ajayspatil7/solar-detect/solar_defect_camera/design/phase2-qa-comparison.png

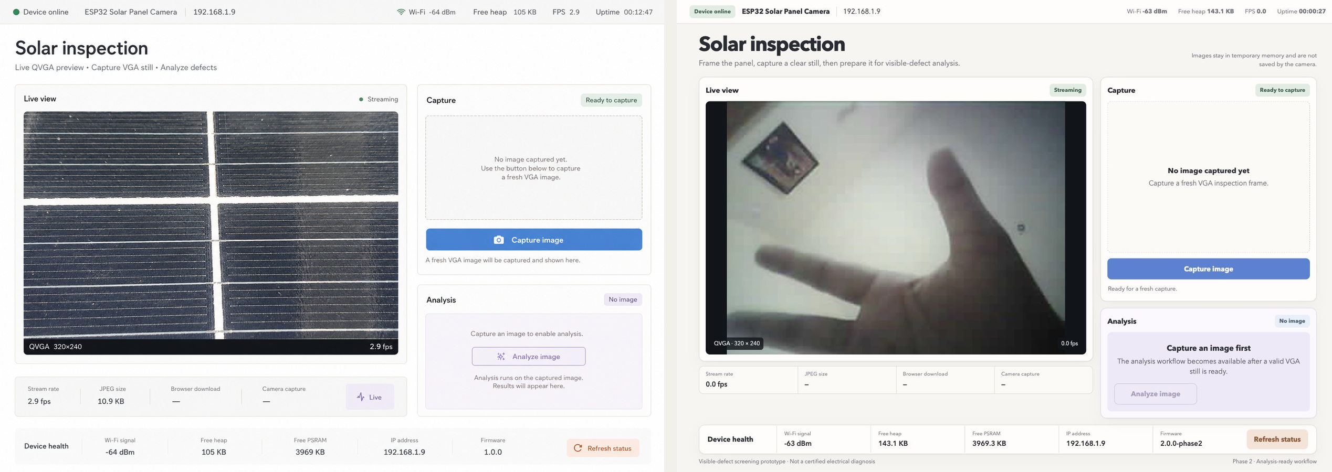
solar_defect_camera/design/phase2-qa-comparison.png
