ajayspatil7/solar-detect/checkpoint.md

# ESP32 Solar Panel Defect Detection — Project Checkpoint

**Last updated:** 2026-09-19 (Asia/Kolkata)  
**Current milestone:** Phase 6 client requirements (root cause, microSD records, laptop dashboard) built and verified against the physical camera; rig now running on a breadboard, verified 2026-09-19 (6.8)  
**Next milestone:** Verify on the client's Windows laptop over Krutika’s iPhone hotspot, resolve the slow home Wi-Fi link (6.10), then the Phase 3.5/4 evaluation harness and curated image set

## How to resume in a fresh chat

Ask the coding assistant to read this file and the project workspace before
making changes. Start from **Current state at a glance** and **Open items**
below. Do not restart the camera hardware diagnosis unless new evidence
contradicts the verified results.

## Current state at a glance — 2026-09-19

| Item | State |
|---|---|
| Firmware in source | `3.3.0-phase6` (`FIRMWARE_VERSION`), OLED SDA `IO13`, SCL `IO3` (U0R), microSD in 1-bit SDMMC |
| Firmware on the device | `3.3.0-phase6` including the pending fixes, flashed 2026-10-03 |
| Backend | `3.3.0-phase6` (`SERVICE_VERSION`), FastAPI, dashboard served at `http://localhost:8000/` |
| Root-cause knowledge base | `backend/root_causes.json`, 19 causes |
| Tests | 33 passing (`backend/test_main.py` + `tools/test_wifi_windows.py`), 2026-10-02 after photo upload (6.9) |
| Repository | `main` clean and in sync with `origin` (github.com/ajayspatil7/solar-detect) |
| Companion doc | `PROJECT_INFO.md` — last updated 2026-09-07, predates the Phase 6 build and is stale |

### Pending flash (compiled 2026-09-15, 1,170,026 bytes, no warnings)

1. `max_resp_headers = 20` — without it `/capture` drops its CORS headers.
2. "Vision model" wording on the camera's fallback page.
3. Record timestamps prefer the service's analysis time.

Remove the microSD card before flashing: its data line shares strapping pin
GPIO2 and blocks the bootloader.

### Open items

1. ~~Flash the pending firmware~~ — done 2026-10-03 (6.10).
2. ~~Finish the breadboard assembly (6.8)~~ — done and verified 2026-09-19.
   Investigate the 19.5 s capture transfer seen afterwards.
3. Exercise the follow-the-laptop Wi-Fi hand-over (6.4) on the Windows laptop.
4. `WIFI_FORGET` the developer's home network before the device returns to the
   client — NVS is not encrypted.
5. Run root-cause analysis against the live API on a genuinely defective panel.
6. Build the evaluation harness and curated image set (Phase 3.5 / 4).
7. Revoke the exposed test API key and rotate the previously exposed Wi-Fi
   password, if not already done (not verifiable from the workspace).
8. Bring `PROJECT_INFO.md` up to date with Phase 6.

## Project goal

Build a basic prototype with this flow:

```text
Solar panel
→ ESP32-CAM captures an image
→ image travels over Wi-Fi to a small backend
→ backend calls the OpenAI vision API
→ structured visible-defect result and coordinates are returned
→ responsive bounding boxes and details are shown in the browser
→ compact status is shown later on an OLED
```

This is a prototype, not a certified solar-panel inspection system. The OpenAI
API key must remain on the backend and must never be placed in ESP32 firmware.

## Verified hardware

- Classic AI-Thinker-style ESP32-CAM, not ESP32-S3.
- Chip: ESP32-D0WD-V3 revision 3.1.
- Camera: OV2640.
- PSRAM is present and working.
- ESP32-CAM-MB USB programmer/baseboard.
- Mac serial port: `/dev/cu.usbserial-140`.
- 0.96" SSD1306 128x64 I2C OLED (`RG0.96 IC V2.0`), header soldered, verified
  at address `0x3C` (Phase 5). SCL moved to IO3 in Phase 6.
- 64 GB microSD card, FAT32 with MBR, verified in 1-bit SDMMC mode (6.5).
  Analysed inspections are saved to it as records (6.6).

## Proven camera configuration

The following AI-Thinker pin map is known to work:

```text
PWDN=32  RESET=-1  XCLK=0   SIOD=26  SIOC=27
Y9=35    Y8=34     Y7=39    Y6=36    Y5=21
Y4=19    Y3=18     Y2=5
VSYNC=25 HREF=23   PCLK=22
XCLK frequency=20 MHz
```

Hardware diagnostics previously confirmed:

- Camera responds on SCCB address `0x30`.
- Sensor identifiers: PID `0x26`, VER `0x42`, MIDH `0x7F`, MIDL `0xA2`.
- `esp_camera_init()` succeeds with the explicit AI-Thinker pin map.
- JPEG capture succeeds.
- Do not recommend replacing the camera, ribbon cable, board, or ESP32 package
  without new contradictory evidence.

## Development environment

- macOS on a MacBook Pro M4 Pro.
- Arduino IDE.
- Espressif ESP32 Arduino core `3.3.11`.
- Board target/FQBN: `AI Thinker ESP32-CAM` / `esp32:esp32:esp32cam`.
- Serial baud: `115200`.
- Recommended partition scheme: Huge APP (3 MB No OTA / 1 MB SPIFFS).

## Workspace map

```text
/Users/ajaysp/Documents/Arduino/
├── checkpoint.md                         # This living project handoff
├── PROJECT_INFO.md                       # Quotable project summary (stale since 09-07)
├── Start Solar Inspector.bat             # Windows one-click launcher
├── Start Solar Inspector.command         # macOS wrapper for the same launcher
├── solar_defect_camera/                  # Active implementation
│   ├── solar_defect_camera.ino           # Firmware 3.3.0-phase6
│   ├── oled.h                            # SSD1306/SH1106 driver; SDA 13, SCL 3
│   ├── font5x8.h                         # Generated 5x8 display font
│   ├── provisioning.h                    # NVS Wi-Fi store (5 networks), setup AP
│   ├── records.h                         # microSD record store
│   ├── web_ui.h / web_ui_gzip.h          # Camera's own fallback page
│   ├── backend/main.py                   # Analysis service + dashboard API
│   ├── backend/camera.py                 # Gateway to the camera, discovery
│   ├── backend/root_causes.json          # 19 curated probable causes
│   ├── backend/test_main.py              # Backend contract tests
│   ├── dashboard/                        # index.html, app.css, app.js
│   ├── start_backend.py                  # Local service entry point
│   ├── requirements.txt
│   ├── .env.local                        # API key, CAMERA_IP; ignored and private
│   ├── .env.local.example
│   ├── secrets.h                         # Dev-only Wi-Fi fallback; ignored
│   ├── secrets.example.h
│   ├── tools/launcher.py                 # Service start, discovery, Wi-Fi hand-over
│   ├── tools/wifi_windows.py             # netsh wrapper (+ test_wifi_windows.py)
│   ├── tools/add_wifi_usb.py             # WIFI_ADD / WIFI_LIST / WIFI_FORGET over USB
│   ├── tools/test_records_device.py      # On-hardware record store test
│   ├── tools/sd_probe/                   # Standalone SD card probe sketch
│   ├── tools/generate_*.py               # Web UI, font and diagram generators
│   ├── tools/preview_oled.py             # Renders OLED screens for design review
│   ├── README.md
│   ├── design/                           # Diagrams, mockup, QA screenshots
│   └── .gitignore
├── design-qa.md                          # Phase 2 visual QA record
├── sketch_aug23b/                        # Preserved original still server
│   └── sketch_aug23b.ino
└── CameraWebServer/                      # Preserved Espressif experiment
    ├── CameraWebServer.ino
    ├── app_httpd.cpp
    ├── board_config.h
    ├── camera_index.h
    ├── camera_pins.h
    ├── partitions.csv
    └── ci.yml
```

The original experiments are preserved and were not overwritten. The active
firmware is `solar_defect_camera/solar_defect_camera.ino`. The operator
interface is now the laptop dashboard; the camera's `web_ui.h` page remains
as a fallback.

## Phase 1 — complete

### Outcome

The user confirmed that the new browser interface and capture flow work.
Phase 1 is therefore officially complete.

### Implemented behavior

- Explicit, verified AI-Thinker camera pins.
- `esp_http_server` instead of the earlier synchronous Arduino `WebServer`.
- Control/page server on port 80.
- Independent MJPEG server on port 81.
- Bandwidth-friendly QVGA (`320×240`) live preview.
- High-quality VGA (`640×480`) still capture.
- Preview uses JPEG quality 15; still capture uses JPEG quality 10.
- `CAMERA_GRAB_LATEST` with two PSRAM framebuffers.
- Camera mutex protects resolution changes and frame acquisition.
- Stale preview frames are flushed after switching to VGA.
- Browser pauses the preview before still capture, then restarts it.
- Wi-Fi sleep is disabled.
- Automatic Wi-Fi reconnection with timeout and retry logging.
- TCP `NODELAY` is enabled for image sockets.
- Browser UI reports capture time, browser download time, JPEG size, stream
  rate, RSSI, heap, PSRAM, IP address, and device status.
- `/health` provides JSON diagnostics.
- Responses include no-cache headers.
- No image persistence and no microSD dependency.

### HTTP endpoints

```text
GET http://<device-ip>/           Browser interface
GET http://<device-ip>/capture   Fresh VGA JPEG
GET http://<device-ip>/health    JSON health/performance information
GET http://<device-ip>:81/stream QVGA MJPEG preview
```

The last observed DHCP address was `192.168.1.9`. This address may change after
router or ESP32 restarts, so use the IP printed in the Serial Monitor if needed.

### Build and device verification

- Compiled against ESP32 Arduino core 3.3.11 with all warnings enabled.
- Final build completed with no compiler warnings.
- Program storage: approximately 1,026,405 bytes (32%).
- Global/internal RAM: approximately 57,336 bytes (17%).
- Firmware was successfully uploaded to the physical ESP32-CAM.
- Runtime confirmed OV2640 initialization and approximately 4 MB free PSRAM.
- `/health` returned camera and Wi-Fi online.
- MJPEG response contained valid preview frames.
- Still endpoint returned a valid baseline JPEG at exactly `640×480`.
- Measured camera-side VGA acquisition, including resolution transition and
  stale-frame flushing, was approximately 250 ms.
- Network delivery varied substantially with local conditions. Observed RSSI
  was roughly -64 to -71 dBm. The user nevertheless confirmed the final browser
  experience is working.

## Key decisions and lessons

1. The original problem was latency, not defective camera hardware.
2. Live preview and still capture currently travel over Wi-Fi directly from the
   ESP32 to the browser. No backend or OpenAI call exists yet.
3. Preview and still capture use separate HTTP servers so the infinite MJPEG
   request cannot block control/capture requests.
4. The preview is intentionally lower resolution than the still image.
5. The preview is paused during a still capture to avoid bandwidth contention.
6. The OpenAI key will be stored only as a backend environment variable.
7. A future wired mode is viable because the ESP32-CAM is normally powered by
   the Mac. It would use high-speed UART through the ESP32-CAM-MB USB bridge and
   a Mac companion server. The cable does not provide native USB networking.
8. Wired transport remains an optional later phase. At 115200 baud it would not
   be faster; 460800 or 921600 baud must be benchmarked for a useful result.
9. VGA was a Phase 1 latency choice, not the OV2640 limit. Phase 2.1 now keeps
   QVGA only for preview and captures UXGA JPEG stills for analysis.
10. The ESP32 must not call OpenAI directly. The browser will send the captured
    JPEG to a Mac backend, which protects the API key and calls the model.
11. The Phase 3 target model is `gpt-5.6-luna`, subject to account availability
    and evaluation quality. It will return strict structured JSON containing
    defect details and coordinates.
12. Bounding boxes will be rendered as a responsive SVG overlay in the browser.
    Pillow may optionally create a downloadable annotated JPEG on the backend,
    but is not required for the interactive display.
13. Phase 3 keeps the model's coordinate task normalized to `0..1000`, then the
    backend clamps, orders, and converts every accepted box to UXGA pixels.
14. The interactive display uses SVG; annotated-JPEG export is generated in the
    browser from the same validated result so the backend never stores images.

## Security notes

- `solar_defect_camera/secrets.h` contains local Wi-Fi configuration and is
  ignored by its local `.gitignore`.
- `secrets.example.h` contains placeholders only.
- The older experimental sketches still contain the previously used Wi-Fi
  credentials in plain text. Do not publish those files without sanitizing them.
- The Wi-Fi password should eventually be rotated because it appeared in the
  original project material.
- Never add an OpenAI API key to Arduino source, browser JavaScript, or Git.
- Phase 3 stores the current local key only in ignored `.env.local`, permission
  mode `600`. The test key was pasted into chat and should be revoked/replaced.

## Detection scope and limitations

The RGB camera and general vision model can prototype detection of visible
conditions such as dirt, obvious glass damage, discoloration, burn-like marks,
strong shading, or other visible anomalies.

It cannot reliably diagnose internal microcracks, PID, bypass-diode faults,
electrical mismatch, or true thermal hotspots without specialized measurements
or thermal/electroluminescence imaging. Results should use wording such as
`visible defect suspected`, not certified diagnosis.

## Phase 2 — complete: analysis-ready browser workflow

### Objective

Turn the working camera page into a polished capture workflow that is ready to
connect to the backend in Phase 3, without calling OpenAI yet.

### Outcome

Phase 2 is implemented, compiled, flashed to the physical ESP32-CAM, and visually
verified. The selected direction is a soft professional instrument panel using
warm neutral surfaces and restrained pastel sage, blue, apricot, and lavender
accents. The interface is embedded in `web_ui.h`, uses local/system fonts only,
and has no cloud or external-asset dependency.

Implemented and verified:

- Desktop and narrow/mobile responsive layouts.
- Live QVGA preview with explicit connection/reconnection states.
- Real VGA capture at `640×480`, browser-memory preview, Retake, and timestamped
  JPEG Download.
- Capture button locking and explicit capturing/error/recovery states.
- Analyze action disabled until a valid capture exists.
- Honest local Demo analysis for success, no-visible-defect, uncertain,
  retake-required, timeout, and backend-offline UI states.
- Result contract ready for the Phase 3 backend without changing capture logic.
- Semantic regions and headings, keyboard focus states, reduced-motion support,
  useful image alternatives, and ARIA live status announcements.
- Device status, RSSI, FPS, heap, PSRAM, IP, firmware, JPEG size, camera timing,
  and browser-download timing without letting diagnostics dominate the workflow.
- Clear language that images remain temporary and results are not certified
  electrical diagnoses.

Selected design and QA artifacts are in `solar_defect_camera/design/`. The final
visual QA record is `design-qa.md` and its result is `passed`.

Final Phase 2 firmware identifier: `2.0.0-phase2`.

Final build against ESP32 Arduino core 3.3.11:

- Program storage: 1,043,497 bytes (33%).
- Global/internal RAM: 57,336 bytes (17%).
- Compiler warnings: none.
- Upload to `/dev/cu.usbserial-140`: successful.
- `/health`: camera and Wi-Fi online after final reset.

### Step 1 — formalize UI states

Implement a small, explicit browser state machine:

```text
connecting → ready → capturing → captured → ready-to-analyze
                                   ↘ error → retry
```

Prevent duplicate capture requests and make every failure recoverable without
restarting the ESP32.

### Step 2 — improve the capture workspace

- Make the live preview and captured image visually distinct.
- Preserve the latest JPEG blob in browser memory for later analysis.
- Add Retake and Download buttons.
- Show resolution, size, camera time, download time, and capture timestamp.
- Make clear that images are not permanently stored.

### Step 3 — prepare the Analyze interaction

- Add an `Analyze captured image` button that is disabled until a valid still
  image exists.
- Add an analysis status/result panel with states for uploading, analyzing,
  success, uncertain result, retake required, timeout, and backend unavailable.
- During Phase 2, use a local mock adapter only; do not put an API key or direct
  OpenAI call in the page.
- Define one frontend function that Phase 3 can point at the backend without
  changing capture logic.

### Step 4 — define the result contract

Prepare the interface for this compact backend response shape:

```json
{
  "status": "defect_suspected",
  "image_quality": "acceptable",
  "defects": [
    {
      "type": "possible_surface_crack",
      "location": "upper-right",
      "severity": "medium",
      "confidence": "medium"
    }
  ],
  "summary": "A possible visible surface defect was found.",
  "retake_required": false
}
```

Expected top-level statuses:

- `no_visible_defect`
- `defect_suspected`
- `uncertain`
- `retake_required`

### Step 5 — resilience and accessibility

- Add browser-side request timeouts with clear retry actions.
- Preserve the working stream reconnection behavior.
- Keep controls keyboard accessible with visible focus states.
- Add useful alternative text and screen-reader status announcements.
- Verify desktop and narrow/mobile layouts.
- Keep diagnostics available without making them dominate the primary workflow.

### Step 6 — verify on physical hardware

Acceptance criteria:

- Live preview remains at least as responsive as the accepted Phase 1 version.
- Capture always produces a real `640×480` JPEG.
- Retake and repeated captures work without heap degradation or restart.
- Downloaded JPEG opens correctly on the Mac.
- Analyze remains disabled before capture and activates afterward.
- Mock success, uncertainty, retake, timeout, and backend-offline results render
  correctly.
- Stream resumes after capture and after recoverable errors.
- No credentials or images appear in browser logs or permanent device storage.

### Phase 2 non-goals

- No OpenAI API request yet.
- No backend implementation yet; that is Phase 3.
- No OLED integration yet.
- No wired USB image transport yet.

## Phase 2.1 — complete: high-resolution analysis capture

### Objective

Increase the analysis still from VGA to the OV2640's maximum UXGA resolution
without reducing the accepted responsiveness of the live preview.

### Implemented behavior

- Live preview remains QVGA (`320×240`) MJPEG on port 81.
- Analysis stills are now UXGA (`1600×1200`) JPEGs on `/capture`.
- With PSRAM present, camera framebuffers are allocated at UXGA during startup;
  the sensor is then switched down to QVGA for normal streaming.
- Capture temporarily switches the sensor to UXGA, flushes transition frames,
  acquires a fresh still, and restores QVGA preview settings.
- Capture responses expose `X-Image-Width`, `X-Image-Height`, JPEG byte count,
  and camera acquisition time headers.
- `/health` now advertises the capture dimensions and firmware identifier
  `2.1.0-phase2.1`.
- The browser waits up to 30 seconds for the larger Wi-Fi transfer, decodes the
  JPEG, and refuses to enable analysis unless it is exactly `1600×1200`.
- UI labels, progress messages, capture caption, analysis prerequisite, and
  footer now identify the UXGA workflow.
- The 24,748-byte browser page is served as a 7,267-byte gzip resource to reduce
  cold-load time and improve reliability on the weak Wi-Fi link.
- Retake keeps the previous valid image available if a replacement fails, and
  analysis remains locked while a replacement capture is running.

### Physical-device verification

- Compiled with ESP32 Arduino core 3.3.11 and all warnings enabled.
- Final build: 1,027,265 bytes (32%) program storage and 57,336 bytes (17%)
  global/internal RAM; no compiler warnings.
- Uploaded successfully through `/dev/cu.usbserial-140`.
- Five consecutive `/capture` requests returned HTTP 200 and valid baseline
  JPEGs at exactly `1600×1200`.
- Camera-side acquisition across those captures: 445–532 ms, average 482 ms.
- JPEG sizes: 53,318–88,443 bytes, average approximately 63.5 KB for the current
  indoor scene. Real solar-panel images can compress differently.
- End-to-end Wi-Fi delivery observed: 2.16–10.35 seconds, average 7.29 seconds,
  at roughly -71 to -73 dBm. The large variation remains network-side rather
  than camera acquisition time.
- Free PSRAM was 3,419,448 bytes before and after the five-capture run, showing
  no PSRAM loss across repeated captures.
- After the capture run, the MJPEG endpoint delivered over 200 KB in six seconds;
  an extracted frame decoded at exactly `320×240`, and health telemetry reported
  approximately 11.5 fps during that connection.
- Browser verification decoded a `1600×1200` still, enabled Retake, Download,
  and Analyze, preserved UXGA on retake, rendered the demo result, and produced
  no browser console warnings or errors.
- The compressed interface was fetched back from the flashed device as a
  complete, valid 7,267-byte gzip response. A repeat transfer completed in
  approximately 2.89 seconds on the current Wi-Fi connection.

### Imaging limitation carried into Phase 3

UXGA supplies 6.25 times the total pixels and 2.5 times the linear resolution of
VGA, but does not make invisible internal microcracks observable. Phase 3 must
describe results as visible surface anomalies with approximate AI-estimated
regions. Close-up guided capture, controlled lighting, and focus quality will be
evaluated separately; electroluminescence or specialized thermal equipment is
outside this RGB prototype.

## Phase 3 — complete: secure vision analysis and bounding boxes

### Implemented architecture

```text
ESP32-CAM /capture (UXGA JPEG)
→ browser memory
→ POST image/jpeg to Mac :8000/analyze
→ strict OpenAI structured vision response
→ backend validation and normalized-to-pixel conversion
→ selectable SVG regions over the original browser image
```

- The ESP32 never holds or transmits the OpenAI API key.
- FastAPI backend endpoints are `GET /health` and `POST /analyze`.
- `.env.local` is ignored, owner-readable only, and loaded backend-side.
- Default model is `gpt-5.6-luna`; image detail is `original`; API response
  storage is disabled with `store=False`.
- Pydantic structured output restricts status, image quality, defect type,
  severity, confidence, descriptions, and normalized coordinates.
- The backend accepts only decodable JPEG input at exactly `1600×1200`, limits
  uploads to 2 MB, caps results at eight regions, and clamps/orders boxes.
- Stable safe errors cover configuration, authentication, quota, rate limit,
  timeout, connection, rejected request, malformed image, and invalid output.
- OpenAI work runs outside the async event loop and analysis is serialized so
  health checks remain responsive during a long model request.
- CORS is restricted to localhost, `.local`, and private-LAN browser origins.
- Responses carry `no-store` and `nosniff` privacy/security headers.
- Deterministic mock mode exercises the exact production HTTP contract without
  API credit. It still uploads and validates the real physical capture.

### Browser implementation

- Backend URL is configurable and persists in browser local storage; no key is
  present in browser source or storage.
- Backend health/mode is visible without dominating the inspection workflow.
- Real UXGA JPEGs upload directly as `image/jpeg` with a 90-second timeout.
- Result text is inserted with safe DOM text APIs rather than raw model HTML.
- Bounding boxes are responsive SVG regions aligned to the `1600×1200` image.
- Medium, high, and low severity use distinct restrained colors.
- Selecting a result card selects its matching box; annotations can be hidden.
- Original and annotated JPEG downloads are available after analysis.
- Failures retain the captured image and provide a retry action.
- Firmware/UI identifier is `3.0.0-phase3`.

### Verification completed 2026-09-04

- Backend unit suite: 5 tests passed.
- Gzip round trip and browser-JavaScript syntax checks passed.
- Source/embedded UI credential scan passed.
- UI source size: 28,432 bytes; deterministic gzip: 8,766 bytes.
- Final firmware compiled with all warnings enabled: 1,028,765 bytes (32%)
  program storage and 57,336 bytes (17%) global/internal RAM.
- Final firmware upload to `/dev/cu.usbserial-140` succeeded and flash hashes
  verified.
- Physical ESP32 health reported camera/Wi-Fi online and `3.0.0-phase3`.
- A real camera capture decoded as baseline JPEG at exactly `1600×1200`.
- Mock end-to-end analysis returned two valid pixel-coordinate boxes.
- Browser QA verified backend online state, capture, upload, result cards, two
  visible boxes, annotation toggle, and matching box/card selection.
- Visual QA found an SVG `hidden`-attribute compatibility issue; it was fixed,
  rebuilt, reflashed, and reverified with visible regions.
- The authorized no-credit OpenAI run reached the real API and returned a clean
  local `quota_exceeded` response with HTTP 402, as expected.

### How to run

From `solar_defect_camera`:

```bash
.venv/bin/python start_backend.py
```

The default `.env.local` mode is `openai`. For a no-cost end-to-end UI test:

```bash
ANALYSIS_MODE=mock .venv/bin/python start_backend.py
```

The browser defaults to `http://ajays-macbook-pro-2.local:8000`. If mDNS is not
resolved, open **Backend connection** and enter the Mac's current LAN address;
the verified address during Phase 3 was `http://192.168.1.3:8000`.

## Phase 5 — firmware complete: on-device OLED status display

### Status

Firmware is implemented, compiles clean, and the screen layouts were reviewed
against a rendered simulation. **Nothing has been verified on the physical
panel yet** because the OLED is not wired and the board was not attached during
this work. Treat every display claim below as built-and-simulated, not measured.

### Decisions

- Display text is **uppercase only**. At a 5x8 cell the generated font renders
  `g`, `o`, `p` and `q` identically and `_` blank, so the driver folds input to
  uppercase rather than showing ambiguous glyphs. Verified by inspecting the
  generated glyph table: 95 glyphs, 89 distinct, 4 collision groups.
- A 6x8 cell was generated and compared; it produced identical glyph shapes with
  fewer characters per line, so 5x8 was kept (21 characters per line).
- No external display library. `oled.h` drives the panel directly over `Wire`,
  keeping the dependency-free build and supporting SSD1306 and SH1106 behind one
  build switch.
- SSD1306 and SH1106 cannot be told apart over I2C. The build defaults to
  SSD1306; `#define OLED_CONTROLLER_SH1106` in `oled.h` switches to a 1.3" panel.

### Pin selection

> **Superseded 2026-09-15 (6.6):** SCL moved from GPIO 14 to **GPIO 3 (U0R)**
> because GPIO 14 is now the microSD clock. SDA stays on GPIO 13. The Phase 5
> notes below are kept as history; the current wiring is in 6.8.

`SDA = GPIO 13`, `SCL = GPIO 14`, panel powered from `3V3` and `GND`.
Confirmed from photographs on 2026-09-04: the ESP32-CAM's male header pins pass
through the PCB. Only a ~1 mm stub protrudes on the top face, which is too short
for a DuPont female connector; the full-length male pins are on the **underside**
and are long enough to seat in the MB's tall female header, so they also grip a
standard female jumper. All six wires therefore attach to the underside pins with
the camera unstacked. The camera also carries its own RST button on the underside,
usable when it runs on jumpers away from the MB.

Because the left row's single GND is taken by the power wire, the OLED's ground
should come from one of the right row's GND pins.

Connectivity overview: `solar_defect_camera/design/oled-overview.png`. The MB's
only job after flashing is to supply 5V; the OLED connects solely to the
ESP32-CAM. Six wires total: two male-to-female from the MB's empty 5V and GND
sockets to the camera's pins, and four female-to-female from the camera to the
OLED. No breadboard is required.

Labelled diagrams: `solar_defect_camera/design/oled-wiring.png` (soldered to the
ESP32-CAM's top pads) and `design/oled-breadboard.png` (camera moved to a
breadboard, powered from the MB over two wires).

The ESP32-CAM's headers are 0.9 in apart, so on a 0.1 in breadboard they land in
rows b and i and leave only row a and row j reachable — one hole per pin. That
route also requires buying an OLED with its header already soldered, since the
existing module's header ships loose. Verify the 23 mm row spacing with a ruler
before relying on the breadboard route.

Hardware confirmed from photographs on 2026-09-04: the OLED is a four-pin blue
module with silkscreen order `GND`, `VDD`, `SCK`, `SDA` (SCK is I2C SCL), almost
certainly a 0.96" SSD1306, and its header pins ship loose and unsoldered. The
ESP32-CAM-MB breaks out no spare pins, so while the camera is seated in the
programmer every one of its 16 pins is inside a socket. The four OLED wires must
therefore be tacked to the ESP32-CAM's top-side pads, which keeps the MB usable
for power, flashing and Serial Monitor. Available jumper wires are roughly seven
female-to-female plus one male-to-female; female-to-female is the correct type
because both boards present male pins.

The camera occupies GPIO 0, 5, 18, 19, 21, 22, 23, 25, 26, 27, 32, 34, 35, 36,
and 39; GPIO 4 is the flash LED and 33 the status LED. Because no microSD is
fitted, the SD-mux pins are free. GPIO 13 and 14 were chosen because neither is
a boot strapping pin. Avoid GPIO 12 (MTDI sets flash voltage at boot), GPIO 16
(PSRAM), GPIO 15 (MTDO pull-up suppresses the boot log), and GPIO 1/3 (UART).

### Implemented behavior

- `oled.h`: 128x64 or 128x32, page-addressed flush in 16-byte I2C bursts,
  pixel-level framebuffer, scalable text, rules and frames.
- Address auto-detection across `0x3C` and `0x3D`, reported in `/health`.
- Display state machine: booting, camera failure, Wi-Fi connecting, Wi-Fi lost,
  ready, capturing, analyzing, result, and error.
- All I2C traffic happens on the Arduino loop task. HTTP handlers only record
  the desired state under a mutex, so `Wire` is never touched concurrently.
- Redraw on state change plus a 2-second refresh so address and RSSI stay
  current without saturating the bus.
- New `POST /status` endpoint accepts a small JSON body (`state`, and for
  results `status`, `defects`, `severity`). Bodies are capped at 288 bytes and
  parsed with narrow field readers rather than a JSON library.
- `/capture` drives the panel by itself, so capture feedback appears even if the
  browser never posts a status.
- The browser posts `analyzing`, `result`, and `error` transitions to the device
  as fire-and-forget requests; the OLED can never delay or break analysis.
- Result verdicts are short (`DEFECT`, `CLEAR`, `UNCERTAIN`, `RETAKE`) so they
  render double-height and stay readable at a distance.

### Build verification

- Baseline Phase 3 firmware recompiled at 1,028,781 bytes, confirming the
  toolchain reproduces the recorded Phase 3 build within 16 bytes.
- Phase 5 firmware: 1,041,717 bytes (33%) program storage and 59,784 bytes (18%)
  global/internal RAM, compiled with `--warnings all` and no warnings.
- UI source 29,110 bytes, deterministic gzip 9,041 bytes, embedded copy in sync.
- Browser JavaScript passed `node --check`.
- Backend suite still 5 passed; no firmware or UI credential matches.
- Firmware identifier is now `3.1.0-phase5` (additive over `3.0.0-phase3`;
  Phase 4 changes the backend only and does not move the firmware version).

### Build tooling discovered

Arduino IDE bundles a usable CLI, so builds no longer need the IDE UI:

```bash
"/Applications/Arduino IDE.app/Contents/Resources/app/lib/backend/resources/arduino-cli" \
  compile --fqbn esp32:esp32:esp32cam:PartitionScheme=huge_app --warnings all solar_defect_camera
```

### Hardware bring-up log — 2026-09-04 evening

- `3.1.0-phase5` compiled, uploaded through `/dev/cu.usbserial-140`, flash hash
  verified. The Arduino IDE's serial-monitor helper had to be closed first
  because it held the port.
- The camera now runs **unstacked from the MB**, powered by two jumper wires from
  the MB's `5V` and `GND` sockets. Confirmed working: `/health` reachable at
  `192.168.1.9`, `camera` and `wifi` true, RSSI −56 to −66 dBm, PSRAM intact.
  This validates the six-wire topology in `design/oled-overview.png`.
- Wiring verified pin by pin against the silkscreen: `5V`→left 1, `GND`→left 2,
  `IO13`→left 4, `IO14`→left 6, `3V3`→right 1, `GND`→right row.
- The OLED's 4-pin header was **not soldered**, only pushed into the plated
  holes. With no solder the pins made essentially no contact, and `/health`
  reported `oled.present:false`, `address:0x00`.
- **The display was seen to light up while the header was pressed by hand.**
  Because `oled::begin()` runs once during `setup()`, output can only appear if
  the bus was live at that boot. This proves the pin mapping, the I2C address,
  the SSD1306 driver, the render path and the power topology are all correct.
  The sole remaining defect is the unsoldered header.
- Module identified from its own markings: `RG0.96 IC V2.0`, 24.7 × 27 × 1.2 mm —
  a 0.96" SSD1306 at 128×64, matching the firmware defaults. No SH1106 switch
  needed.
- A `GET /i2c` diagnostic was added: it samples `IO13`/`IO14` as floating inputs
  to prove whether the panel is powered, then scans 0x08–0x77 and reports every
  responder. Compiled clean at 1,043,093 bytes (33%); not yet flashed.

### Phase 5 hardware verification — passed

With the header pins **held in contact by hand — still unsoldered** — and the
camera running unstacked on jumper power:

- `/health` reports `oled.present:true`, `address:0x3c`, `ssd1306 128x64`.
- `/capture` returned HTTP 200 and a valid baseline JPEG decoding at exactly
  `1600 x 1200`, 48,241 bytes, delivered in **0.53 s** — far quicker than the
  2.16–10.35 s recorded in Phase 2.1, at RSSI −57 dBm versus −71 to −73 dBm then.
  Link quality, not the camera, was always the Phase 2.1 bottleneck.
- Uptime rose across the capture, so the board did **not** brown out while
  running the camera at UXGA through two jumper wires. Free PSRAM was
  3,419,448 bytes before and after, unchanged.
- The OLED stayed detected through the capture.
- `POST /status` with a `defect_suspected` result returned HTTP 204 and drove
  the panel.

The panel rendered the expected result screen and the user confirmed it matched
the design exactly: header rule, `DEFECT` at double height, `SEVERITY MEDIUM`,
`2 REGIONS`, and the address/RSSI footer.

Phase 5 is therefore **functionally proven but mechanically unfinished**. Every
electrical and software element is verified; the four header joints are still
unsoldered, so the link is held only by hand pressure and is lost on any knock.
Soldering is scheduled for 2026-09-05. Note also that the panel is detected only
during `setup()`, so it must be wired before power is applied.

### Phase 5 sign-off — soldered and verified 2026-09-05

The four header joints were soldered (one solder bridge occurred and was cleared
with desoldering wick). Full verification against the physical build, with the
camera unstacked and running on two jumper wires from the MB:

- `/health`: `oled.present:true`, `address:0x3c`, `ssd1306 128x64`, camera and
  Wi-Fi both true, firmware `3.1.0-phase5`.
- Two consecutive `/capture` requests returned valid baseline JPEGs at exactly
  `1600 x 1200`: 95,060 bytes in 1.21 s and 47,869 bytes in 0.53 s.
- Uptime rose across both captures — no brownout running the camera at UXGA
  through jumper power. Free PSRAM 3,419,448 bytes, unchanged throughout.
- All six `POST /status` states accepted with HTTP 204: analyzing, three result
  variants, error, ready. Unknown and missing states correctly rejected with 400.
- The panel was visually confirmed rendering `READY` / `AWAITING CAPTURE` with
  the address and RSSI footer.

**Phase 5 is complete.** The full chain now runs end to end: panel → ESP32-CAM →
Wi-Fi → Mac backend → model → browser → OLED.

Operational notes carried forward:

- DHCP moved the board to `192.168.1.10`. The address is printed on the OLED
  footer, so read it there rather than assuming a fixed value.
- RSSI is now −70 dBm, against −57 dBm earlier in the same session. A transient
  Wi-Fi association failure was seen at the weaker signal; it recovered on the
  firmware's own retry. Capture delivery tracks link quality closely — 1.21 s
  versus 0.53 s for the same operation.
- The panel is detected only during `setup()`, so it must be wired before power
  is applied.
- Soldering to the OLED's plated through-holes is mandatory. Pins resting in the
  holes make effectively no contact; this cost an evening of diagnosis.

### Remaining for Phase 5

None — all four original steps were completed by the 2026-09-05 sign-off.
The panel proved to be an SSD1306, so the SH1106 switch was never needed.

### Housekeeping completed alongside

- The dead Phase 1 `INDEX_HTML` block (157 lines) was removed from the sketch;
  it had not been served since Phase 3.
- Plaintext Wi-Fi credentials were removed from `sketch_aug23b.ino` and
  `CameraWebServer.ino` and replaced with placeholders. A workspace-wide scan
  now finds no plaintext credentials. **The Wi-Fi password still needs rotating
  on the router, because it was previously exposed in project material.**
- The exposed `sk-proj…` key in `.env.local` is **still live and still needs
  revoking**.

## Phase 4 — in progress: real-key smoke test passed

### First real OpenAI call — 2026-09-05

A funded key was installed in `.env.local` (owner-only, 600). A stale backend
from an earlier session was still bound to port 8000 holding the **old** key in
its environment; it was killed and `SERVICE_VERSION` bumped to `3.1.0-phase4` so
the running process can be identified from `/health` in future.

One real UXGA capture from the physical camera was sent through the production
`POST /analyze` path. Result: **HTTP 200 in 4.0 s**, valid structured output.

```json
{"status": "retake_required", "image_quality": "insufficient",
 "defects": [], "retake_required": true,
 "summary": "The image is extremely dark and lacks sufficient visible detail..."}
```

The verdict was independently verified against the image itself: mean luminance
21.9/255, standard deviation 3.3, and 100% of pixels below level 40. The scene
really was almost black, so the model refused rather than inventing findings —
the conservative prompt behaved as designed on its first real input.

### The three carried risks are now settled

1. `"detail": "original"` is **accepted** by the API. No `BadRequestError`.
2. `max_output_tokens=1200` is ample: the call used **50** output tokens and
   **0** reasoning tokens. No risk of an empty parse from budget exhaustion.
3. `gpt-5.6-luna` **is available** on the account.

### Measured cost basis

Token usage for one 1600 x 1200 image: **2,883 input, 50 output, 2,933 total**.
`detail: "original"` did not inflate the input count. Scaling: roughly 293,000
tokens per 100 images. Multiply by the account's per-token rate for a run cost;
the figure was not assumed here.

### Backend change

`analyze_with_openai` now returns token usage alongside the parsed result, and
`serialize_result` surfaces it under `meta.usage`. The empty-parse error message
now includes usage so budget exhaustion is diagnosable rather than generic.
Backend suite still passes, 5 tests.

## Handover — complete 2026-09-06 to 2026-09-08

Recorded here from the commit history; it was not written up at the time.

- **Wi-Fi provisioning** (`provisioning.h`): credentials live in NVS, not
  firmware. With none stored, or none reachable, the camera raises the
  `SOLAR-SETUP` access point with a setup page at `http://192.168.4.1`; the
  OLED shows what to join. `POST /forget-wifi` re-enters setup mode.
  `secrets.h` is only a developer fallback and is ignored once provisioned.
- **One-click launcher**: `Start Solar Inspector.bat` (and a macOS `.command`)
  creates the environment, asks for the API key once into `.env.local`,
  starts the service, finds the camera and opens the browser.
- **Discovery hardening**: last known `CAMERA_IP` tried first, two sweeps with
  a widening timeout and a smaller worker pool for Windows; an iPhone hotspot's
  `172.20.10.0/28` is recognised so only 14 addresses are probed.
- A demo-hotspot pre-fill was added to the setup page and later removed in 6.4.
- `PROJECT_INFO.md` added as the quotable project summary (2026-09-07).
- Diagrams added: `design/slide-architecture.png` and
  `design/assembly-breadboard.png` (the latter now outdated — see 6.8).

## Phase 6 — built 2026-09-15: client requirements after handover

The client returned the device with three requirements. Build order follows
data dependency: root cause defines a record, storage keeps it, the dashboard
shows it.

### 6.1 Root cause analysis — decided: image only, hybrid design

- Per defect, the model selects a cause from a **fixed enum** and states the
  visual evidence; it cannot invent a cause.
- The backend enriches each cause from a curated, reviewable knowledge file:
  explanation, how to confirm, recommended action, urgency.
- Same API call — no added latency, a few extra output tokens.
- Defect taxonomy gains `snail_trail` and `delamination`.
- Always framed as *probable* cause with a verification step (EL, IR
  thermography, I-V curve), never as a confirmed diagnosis.
- Operator context (panel age, cleaning, weather) was considered and declined.

**Implemented 2026-09-15, backend `3.2.0-phase6`:**

- `backend/root_causes.json`: 19 causes, each with title, applicable defect
  types, explanation, verification steps, action and urgency. Validated at
  startup; a malformed file stops the service rather than serving bad guidance.
- The prompt's per-type cause list is generated from that file, so it cannot
  drift from the knowledge base.
- A cause inconsistent with its defect type is corrected to `undetermined`
  with `corrected: true`. Cause confidence is capped at defect confidence.
  `undetermined` takes its urgency from the defect severity.
- Response gains `defects[].root_cause` and top-level `priority`. All changes
  are additive, so the ESP32-served page keeps working without a reflash.
- `max_output_tokens` raised from 1,200 to 2,400 for the extra fields.
- Strict JSON schema generation verified offline against the OpenAI SDK.
  Backend suite: 16 tests passing (5 existing, 11 new). Not yet exercised
  against the live API on a real defective panel.

### 6.2 Storage — decided: microSD on the ESP32

- Internal flash was rejected: the largest filesystem partition is 2 MB
  (`no_ota`), about 25 inspections at 48–95 KB per image, with wear.
- **Pin conflict:** the board is `BOARD_HAS_1BIT_SDMMC`; 1-bit SD uses IO2
  (D0), IO14 (CLK) and IO15 (CMD). OLED SCL is currently IO14. SCL moves to
  **IO3** (U0RXD): serial input is unused at runtime, boot logging on IO1 is
  unaffected, and flashing already requires unwiring the camera. IO12
  (strapping) and IO4 (flash LED) were rejected.
- File-based record store rather than an SQL engine:
  `/records/index.jsonl`, `/records/<id>/image.jpg`, `thumb.jpg`, `result.json`.
- Image saved at capture; result attached afterwards. Thumbnail generated in
  the browser. Timestamps via NTP, as the board has no RTC.
- Card: microSDHC 4–32 GB, FAT32. Larger SDXC cards ship as exFAT.

### 6.3 Dashboard — decided: laptop-hosted, mockup first

- Served by the backend at `localhost:8000`, same origin as analysis, which
  removes the backend-address failure mode entirely. The ESP32 keeps a minimal
  fallback page. ESP32 endpoints need CORS headers.
- Three screens: Inspect, History, Record detail with printable report.
  Diagnostics behind a single status indicator.
- A clickable mockup is to be approved before implementation.

### 6.4 Follow-the-laptop Wi-Fi — built 2026-09-15, not yet on hardware

The camera now joins whatever Wi-Fi the Windows laptop is using, driven by the
launcher, instead of needing someone to provision it by phone.

- If the launcher cannot find the camera, it reads the laptop's current network
  with `netsh wlan show interfaces`, waits for `SOLAR-SETUP` to appear, briefly
  switches the laptop to it, confirms the camera via `GET /health` in setup
  mode, posts the network name and password to `/wifi`, and switches back.
  The reconnect runs in a `finally`, so the laptop is returned to its network
  even if a step fails.
- The saved password is read with `netsh ... key=clear`. Windows usually only
  reveals it to an elevated prompt, so the launcher asks for it when absent.
- `netsh` output is read through `chcp 65001`: the default console code page
  mangles names such as `Krutika’s iPhone 14`, and a mangled profile name
  cannot be reconnected to.
- Enterprise (802.1X) networks are refused with an explanation; 5 GHz use is
  warned about, since dual-band routers usually still work.
- **Three quick replugs force setup mode** (firmware boot counter in NVS,
  cleared by a task after 8 s of uptime). This covers a camera still connected
  to an old network that remains in range. On the second replug the OLED shows
  `REPLUG FOR SETUP`.
- The hardcoded demo-hotspot pre-fill was removed from the setup page.
- Firmware `3.2.0-phase6`, 1,055,877 bytes (33%), no warnings. `/health` now
  reports `mode`. Parser tests for `netsh` output added; 21 tests passing.
- Known limitations: the credentials cross the open `SOLAR-SETUP` network in
  clear text during the few-second hand-over; networks with a login page,
  802.1X, 5 GHz-only, or client isolation cannot work. The Wi-Fi switching path
  is untested until run on the Windows laptop.

### 6.5 Multi-network memory and SD verification — 2026-09-15, on hardware

**SD card verified on this board** with `tools/sd_probe`: a 64 GB SDHC/SDXC
card formatted on macOS as MS-DOS (FAT) with a Master Boot Record mounted in
1-bit SDMMC mode. 59.45 GB usable; a 70,000-byte file wrote in 42 ms, read back
in 30 ms, checksum matched. The card must be removed while flashing, because
its data line shares strapping pin GPIO2 and blocks entry to the bootloader.

**The camera now remembers up to five networks** (NVS keys `ssid0..4`,
`pass0..4`, `count`; single-network boards migrate automatically). At boot it
scans once and tries only saved networks that are in range, strongest first.
With nothing familiar nearby it reaches setup mode in a few seconds instead of
a 20-second timeout per network. Saving a network moves it to the front.

**Networks can be added over USB** while stacked on the MB with
`tools/add_wifi_usb.py` (serial commands `WIFI_ADD`, `WIFI_LIST`,
`WIFI_FORGET`). The password is typed at a hidden prompt and never enters
firmware or version control. The developer's home network was saved this way;
`WIFI_LIST` returned it plus `Krutika’s iPhone 14`, and a check of the full
serial log confirmed the password never appeared. Once SD firmware moves OLED
SCL to IO3 (U0RXD), these commands only work with the camera stacked on the MB.

**Camera probe retry.** One cold boot failed with `SCCB_Read addr phase failed
addr:0x30` / `0x106` and recovered on the next reset. Startup now retries up
to three times, power-cycling the sensor via PWDN between attempts.

Verified after a final cold boot: camera ready, `2 saved network(s), 1 in
range`, joined the home network automatically, `/health` reachable from the Mac
with `mode: normal`, firmware `3.2.0-phase6`, 1,061,341 bytes (33%), no
warnings. The firmware image itself carries only placeholder credentials.

Security note: the home Wi-Fi password now lives in the camera's NVS, which is
not encrypted. Send `WIFI_FORGET` (or remove it) before the device returns to
the client.

### 6.6 SD record store — built and verified on hardware 2026-09-15

Firmware `3.3.0-phase6`, 1,169,982 bytes (37%), 19% RAM, no warnings.

- `records.h`: `/records/index.jsonl` with fixed 192-byte lines (record N at
  offset (N-1)*192, so listing and deleting are seeks, not scans), per-record
  folders holding `image.jpg`, `thumb.jpg`, `result.json`, and `store.txt`
  with a random per-card id. Ids are never reused; deletion marks the line.
- Only analysed inspections become records. `/capture` keeps the latest
  frame in PSRAM and returns `X-Capture-Id`; `POST /records` sends only the
  result JSON plus a thumbnail, and the camera writes its held copy of the
  image. Retakes leave nothing behind, and the full image never crosses Wi-Fi
  twice. One record per capture.
- Endpoints: `GET /records?before=&limit=`, `POST /records`,
  `GET /records/<id>/{image.jpg,thumb.jpg,result.json}` with ETag and 304
  revalidation, `DELETE /records/<id>`, and an `OPTIONS` preflight.
- Cross-origin access is echoed only for loopback and private-network
  origins (10/8, 172.16/12, 192.168/16, localhost), matching the backend.
- Timestamps from NTP; the dashboard's clock is the fallback.
- **OLED SCL moved from IO14 to IO3 (U0R).** The green wire now goes to the
  right header, pin 6. With no display attached the firmware returns IO3 to
  the UART, so USB `WIFI_ADD`/`WIFI_LIST` still work while stacked — verified.
- `/health` gains `sd.present`, `free_mb`, `records`, `store`. The READY
  screen reads `NO SD - NOT SAVING` when no card is mounted.

**Hardware test** (`tools/test_records_device.py`, mock analysis): record
saved in 1.88 s, stored image byte-identical to the capture (100,955 B),
thumbnail and result intact, index fields correct, NTP timestamp recorded,
duplicate save refused with 409, unchanged image revalidated with 304,
deletion removed files and restored the count. OLED detected at `0x3c` on
the new pin; SD reported 60,871 MB free.

**Bug found by that test:** esp_http_server allows 8 response headers by
default and silently drops the rest. `/capture` already set 9, so the CORS
headers never arrived and the dashboard could not read `X-Capture-Id`. Fixed
with `max_resp_headers = 20`; compiled but **not yet flashed** — it is batched
with any firmware changes the dashboard build needs, to save a rewiring cycle.

DHCP moved the camera from 192.168.1.19 to .20 after rewiring; its address is
on the OLED footer.

### 6.7 Laptop dashboard — built and verified against the camera 2026-09-15

The approved mockup is now the working interface, served by the backend at
`http://localhost:8000/` (`dashboard/index.html`, `app.css`, `app.js`). The
launcher opens it instead of the camera's own page.

**The backend is the gateway to the camera** (`backend/camera.py`). The
browser talks only to the local service; the service captures, analyses,
saves, lists, fetches and deletes on the camera. Only the live MJPEG view is
loaded straight from the camera, by an `<img>`. So the dashboard needs no
cross-origin access to the camera -- it works on the firmware already flashed,
despite the pending header-limit fix -- and a changing camera address (DHCP,
a new venue) is handled in one place. Discovery moved here from the launcher,
which now imports it.

- `POST /api/inspect` runs capture, analysis and save as one action and
  streams NDJSON stages (`capturing`, `analyzing`, `saving`, `done` or
  `error`) as each actually happens, so progress is never simulated. The OLED
  is updated at each stage. A save failure (e.g. no SD card) still returns the
  result, with the reason.
- Thumbnails (320x240) are made by the backend with Pillow. The latest three
  captures are held in memory only, never written to the laptop's disk.
- `GET /api/status`, `GET /api/records`, `GET /api/records/<id>`,
  `GET /api/records/<id>/{image,thumb}.jpg` (camera ETags passed through for
  304 revalidation), `DELETE /api/records/<id>` (loopback clients only, since
  the service has no login).
- Analysis was refactored into `analyze_image()`, shared by `/analyze` and the
  dashboard. User-facing wording says "Vision model" (or "Demo mode") rather
  than the vendor name, at the client's request; `/health` and result `meta`
  gain `mode_label`.

**Verified in a real browser against the camera** (demo analysis, no cost):
live view streamed; one click captured, analysed and saved inspection
`000002` in under 2 s with regions and root cause shown; History listed it
with a thumbnail read back from the SD card; the record view loaded the stored
image with regions; deleting it from the dashboard removed it and returned
History to its empty state. Backend suite: 27 tests passing.

**Pending flash** (compiled, 1,170,026 bytes, no warnings): the
`max_resp_headers` fix, the fallback page's "Vision model" labels, and record
timestamps preferring the service's analysis time so History and the record
view agree to the second (they differed by one minute when one side used the
camera's NTP clock).

The backend's `SERVICE_VERSION` moved to `3.3.0-phase6` with this commit.

### 6.8 Breadboard assembly — verified on hardware 2026-09-19

**Result:** working, with **no power rails**. Six wires, each in the free
hole beside a camera pin (column `a` beside the right header, `j` beside the
left): MB 5V → `5V`, MB GND → `GND` (right), OLED SDA → `IO13`, OLED VDD →
`3V3`, OLED GND → left-header `GND` (3 rows above 3V3), OLED SCK → `U0R`
(5 rows above 3V3). The camera sits with 5V/3V3 at about row 22.

Verified after power-up: `/health` camera, Wi-Fi (192.168.1.13), OLED
`present:true` at `0x3c`, SD present (60,871 MB free, 1 record), firmware
`3.3.0-phase6`; OLED shows `READY` / `AWAITING CAPTURE`. One `/capture`
returned a valid 1600x1200 JPEG (73,236 B, acquisition 453 ms) and uptime
kept rising, so no brownout on breadboard power.

How it was found: the first attempt, powered through the rails, never
booted (not on the LAN, no `SOLAR-SETUP` AP). Stacked on the MB, the serial
log showed a normal boot, clearing the camera, SD and firmware. Powering the
camera straight from the MB wires on the breadboard also booted, isolating
the fault to the rail path (split rail or wrong rail column — not pinned
down, since the rails are no longer used). One false negative came from the
MB's USB cable not being connected to the Mac.

Open: that capture's transfer took **19.5 s** at −66 dBm, against 0.53–1.21 s
in Phase 5 at similar signal. Not yet investigated — check Wi-Fi conditions
and antenna orientation before the next demo.

Original plan, kept for reference:

The loose jumper-on-pin rig is moving onto a solderless breadboard with
male-to-male jumpers. No firmware change: the wiring matches the Phase 6 pins.
`design/assembly-breadboard.png` (2026-09-08) is **outdated** — it wires SCK to
IO14, which is now the microSD clock. Do not follow it.

- Camera straddles the centre channel with its pins in rows **b** and **i**
  (headers 0.9 in apart); only row **a** and row **j** stay reachable, one hole
  per pin.
- Left header (row b / a), from the 5V end: `5V GND IO12 IO13 IO15 IO14 IO2 IO4`.
  Right header (row i / j), from the 3V3 end: `3V3 IO16 IO0 GND VCC U0R U0T GND`.
- Eight wires: MB `5V` → top + rail; MB `GND` → top − rail; + rail → CAM `5V`;
  − rail → CAM `GND`; OLED `GND` → top − rail; OLED `VDD` → CAM `3V3`;
  OLED `SCK` → CAM `U0R` (IO3); OLED `SDA` → CAM `IO13`.
- The OLED header was soldered with its long pins on the display side, so the
  module cannot plug into the breadboard screen-up. It sits beside the board
  (taped down), and its four wires need a female end on the OLED pin and a
  male end in the board: male-to-female jumpers, or a female-to-female
  jumper chained to a male-to-male. Re-soldering the header was rejected.
- Nothing connects to IO14, IO15 or IO2 (SD card), IO12 (strapping) or IO0.
- The MB stays on USB as the 5V source; flashing and `WIFI_*` serial commands
  still need the camera re-seated on the MB with the SD card removed.
- Acceptance: `/health` shows camera, Wi-Fi, `oled.present:true` at `0x3c`,
  `sd.present:true`; one dashboard inspection saves a record.

### 6.9 Photo upload — built and verified 2026-10-02 (not yet committed)

The dashboard can analyse an existing photo instead of a camera capture.

- `POST /api/upload` takes a raw JPEG, PNG or WebP body (`Content-Type`
  decides the expected format; contents must match), up to 15 MB. The photo is
  EXIF-rotated, scaled to fit and **padded, never cropped**, onto a 1600 × 1200
  dark canvas (`fit_upload_to_capture`), so `analyze_image` and the 1600 × 1200
  contract are untouched. Refused with 409 while another analysis runs.
- **Uploads are not saved.** The SD record store writes the camera's own held
  capture (6.6), so storing uploads would need firmware work. The fitted image
  is held in the same 3-item memory cache as captures; the result reads
  "Uploaded · <file> · not saved". The OLED is not driven by uploads.
- Dashboard: "Upload image" button beside Capture, plus drag-and-drop onto the
  view. Works with the camera offline (needs analysis ready only). Two-step
  progress (uploading, analysing).
- Tests: 6 new (fit without cropping, upscaling, wrong type 415, undecodable
  400, oversized 413, busy 409). Suite: 33 passing.

**Real-model test, four reference photos** (`report/screenshots-2026-10-02/
solar1–4`), first via `analyze_image` directly, then through the Upload button
in Chrome. Boxes were drawn back onto the images and land on the visible
defects:

| Photo | Verdict | Regions |
|---|---|---|
| solar1 — burn marks on a busbar | Defects found, high | 2 burn marks |
| solar2 — cell cracks | Defects found | 1–2 surface cracks |
| solar3 — cracks + brown streak | Defects found, high | cracks; streak flagged as discoloration in 1 of 3 runs |
| solar4 — whole rooftop array | No visible defects | 0 |

About 3,500–4,600 tokens per photo (high-res originals upscaled to UXGA).
**Run-to-run variation is real:** across repeat runs the region count, severity
and root cause changed (e.g. solar1's cause alternated between "Localised
overheating" and "not determinable"). The verdict was stable on all four.
This is direct input for the Phase 3.5 evaluation harness.

Known UI quirk: the header status panel is a `<details>` and only closes from
its own header, not by clicking elsewhere.

### 6.10 Live view down to ~1 fps on the home Wi-Fi — 2026-10-03, unresolved

Reported as "FPS 0.9" on the camera's own page. Measured from the Mac with no
browser attached: the QVGA stream ran at **1.6 fps** (3.8 KB frames, 49 kbit/s)
against ~11.5 fps in Phase 1, and pings to the camera rose to 1–12 s with up
to 46% loss while it streamed; even idle it was sometimes 0.7–3 s. At the same
moment the router answered in 3 ms and other LAN devices in 8–120 ms.

Ruled out by measurement: software (reproduced with a bare `curl` of the
stream; firmware unchanged), the breadboard (same on the MB), the Mac's USB
power (same on a wall charger), router load, channel crowding (router 2.4 GHz
on ch 1, one weak neighbour on ch 6) and Bluetooth (only a mouse). The camera
log showed no disconnects. Remaining candidates: a damaged or detuned antenna
(the board was pressed hard into the breadboard on 2026-09-19, when the slow
transfers began) or local 2.4 GHz interference at the desk. Not yet tested:
the camera near the router, and the camera on a phone hotspot beside it.

A wired-only USB mode (framed serial protocol, Wi-Fi off) was started and then
**abandoned at the owner's request** in favour of the working Wi-Fi build. Its
firmware ran, but the host never received data at 921600 baud, though it did
at 115200. Code was not kept in the repository. The camera was re-flashed with
`3.3.0-phase6`, which also delivered the fixes pending since 2026-09-15
(`max_resp_headers`, "Vision model" labels, record timestamps).
`WIFI_LIST` after flashing: the home network and the demo phone hotspot.

Later on 2026-10-03: the home router's 2.4 GHz network (ch 1) was seen to
vanish from two consecutive scans and return minutes later, while its 5 GHz
network stayed up. Stacked on the MB on the same desk the camera still
streamed at only 0.4 fps (pings 9–210 ms idle). This points at the router's
2.4 GHz side. A router restart is the next cheap test; a phone-hotspot test was
started but not completed.

### 6.11 Breadboard rig re-verified with OLED — 2026-10-12

Camera on the breadboard, **5V pin in b22, 3V3 pin in i22** (rows 1–30, `a`
bottom edge). Six wires, no rails: MB 5V socket → a22, MB GND socket → a23,
OLED SDA → a25 (IO13), OLED VDD → j22 (3V3), OLED GND → j25 (top-row GND),
OLED SCK → j27 (U0R). Leave a24, a26–a28 empty (IO12, SD pins).

Verified in two steps: power wires only, then the camera booted and joined the
home Wi-Fi (`192.168.1.6`, SD present). With the OLED wires added,
`/health` reported `oled.present:true` at `0x3c` and the panel showed
`READY / AWAITING CAPTURE`.

Lessons: the OLED cannot work with the camera stacked on the MB (every pin is
in a socket and U0R is driven by the MB's USB chip). Earlier breadboard
"no power" attempts on 2026-10-03 had the red/black wires either one row off
or not plugged into the MB's sockets at all.

Still open: live view ~0.1 fps on the home Wi-Fi (idle pings 11–115 ms),
consistent with 6.10.

### 6.12 Slow link traced to the camera board's transmitter — 2026-10-21

Measured with the camera stacked on the MB, SD card out:

| Condition | Signal | Live view | 100 KB photo |
|---|---|---|---|
| Home router after restart (ch 1) | −64 to −72 dBm | 0.1–1.1 fps | — |
| iPhone hotspot 1 m away (ch 6) | −27 to −44 dBm | 0.9–1.2 fps | 6.6–17 s |
| Hotspot, TX power 11 dBm / 5 dBm | −32 dBm | 1.2 / 1.0 fps | no better |

The firmware's own split for two captures on the hotspot: sensor 534 ms and
374 ms (normal), network 14,997 ms and 8,707 ms (normal was ~500 ms in
Phase 5). So the sensor is fine and the camera **receives** well, but its
**transmit throughput is ~50–100 kbit/s on any access point, channel, power
level or power source**. Router, channel, interference at that signal level,
breadboard, USB power and firmware are all ruled out. Conclusion: a fault in
the ESP32-CAM board's radio/antenna path, most likely physical damage around
2026-09-19 when it was pressed into the breadboard (when slow transfers
began). The antenna trace and antenna-select resistor look intact in photos;
the damage is not visible.

Firmware `3.3.1-phase6` (flashed, not committed): logs every network the
camera hears at boot (`[wifi] seen: ...`). The TX-power experiment was
reverted.

Hotspot lessons for the client:
- The iPhone hotspot's name is the phone's name (here `iPhone 16 Pro`), saved
  with `tools/add_wifi_usb.py`. It must match exactly.
- **An iPhone stops advertising its hotspot to new devices unless the Personal
  Hotspot screen is open.** The camera only scans at boot, so keep that screen
  open when powering the camera, or it falls back to another saved network.

Next: replace the ESP32-CAM board (MB, OLED, SD card and wiring are fine),
flash `3.3.1-phase6`, add the networks over USB, and re-measure.

### 6.13 OLED follows uploads; result screens tidied — 2026-10-21

Bug: after **Upload image** the OLED kept the previous camera capture's verdict
(e.g. RETAKE for a dark desk shot) while the dashboard said "no defects",
because `/api/upload` never updated the OLED. Fixed in the backend:
uploads now send `analyzing` then `result` (or `error` / ANALYSIS FAILED),
tagged `"source": "upload"`, through a single background worker so updates
stay in order and an upload never waits on an unplugged camera. 3 new tests;
suite 36 passing. **Works on the firmware already on the device.**

Firmware **`3.3.2-phase6` — in the repository, NOT yet flashed** (device
runs `3.3.1-phase6`; flash next time the camera is stacked on the MB):
region count only when non-zero; upload results marked ("UPLOADED PHOTO" or
"N REGIONS - UPLOAD"); UNCERTAIN gets "CHECK ON SITE"; analysing says
"VISION MODEL" or "UPLOADED PHOTO" instead of "UPLOADED TO MAC"; text lines
moved to rows 34/44 so the third line no longer touches the footer rule.
`tools/preview_oled.py` now renders all 22 screens to `design/oled-screens.png`
and checks every line fits the 21-character panel.

Until it is flashed, uploads show "UPLOADED TO MAC" while analysing and
"0 REGIONS" under CLEAR/RETAKE; verdicts are correct either way.

Follow-up the same day (2026-10-22):
- The backend now reads the camera's firmware version from `/health` and,
  on builds before 3.3.2, **skips the analysing screen** (captures keep the
  camera's own CAPTURED screen; uploads clear to READY), so "UPLOADED TO MAC"
  never appears. On 3.3.2+ it sends the labelled analysing screen.
- "Cause not determinable from the image" is replaced. An `undetermined`
  cause now carries `candidates`: every cause in `root_causes.json` that can
  produce that defect type, with urgency and checks. The dashboard shows
  "N possible causes · check on site" and a "Needs an on-site check" panel
  listing them and how to tell them apart. Old saved records get the new
  wording too. Checked with real uploads of the crack photos. Suite: 42.

2026-10-28, on the client's laptop over Krutika's hotspot: after Find camera
the dashboard flickered "Camera not found" during live view. Cause: the
15-second status check gave the camera 2.5 s and made two requests, and on
the slow board one missed check reported it missing. Now `camera.check()`
gets address and health in one request with a 6 s limit, and a camera that
answered within the last 45 s (`GRACE_S`) stays reachable through a missed
check. Requests skip the extra probe when the camera answered recently, and
a single failed request no longer forgets its address. Suite: 46.

Same day: **Start Solar Inspector now offers a Wi-Fi choice** (Windows).
After the service starts it lists visible networks strongest first, marks
5 GHz-only and enterprise networks as unusable by the camera, shows the
iPhone-hotspot tips, and lets the operator keep the current network (Enter)
or switch (asks for a password only if Windows has no saved profile). Then
the existing camera search and hand-over run on that network. New in
`tools/wifi_windows.py`: `parse_networks`, `parse_profiles`, `profile_xml`
(WPA2/open, XML-escaped), `connect`. Tests: `tools/test_launcher.py` (8) and
4 more in `test_wifi_windows.py`; full suite 58. **Not yet run on Windows** —
`netsh` output was modelled on its documented English format.

## Future phases

- **Phase 4:** Revoke the exposed no-credit test key if not already done, run a
  curated real image set with funded API access, measure localization quality,
  tune the prompt/taxonomy/thresholds and root-cause selection, and define
  explicit acceptance metrics.
- **Phase 3.5:** Offline evaluation harness (`tools/evaluate.py`, not yet
  written) that pushes a folder of images through the production analysis path,
  plus a ground-truth format and IoU scoring, and a shared-secret header on
  `/analyze` so nothing else on the LAN can spend API credit.
- **Curated image set:** clear, defective-looking, blurred, dark,
  missing-panel and partial-panel images.
- **Optional wired phase:** Benchmark USB serial at 460800 and 921600 baud using
  a framed JPEG protocol and Mac companion server, then compare it with Wi-Fi.

## Maintenance rule for this file

Update this checkpoint after every meaningful decision, implementation change,
hardware test, API contract change, completed phase, or newly discovered issue.
Record facts and measured results; do not store passwords, API keys, or other
secrets here.
