ajayspatil7/solar-detect/solar_defect_camera/design/oled-breadboard.png

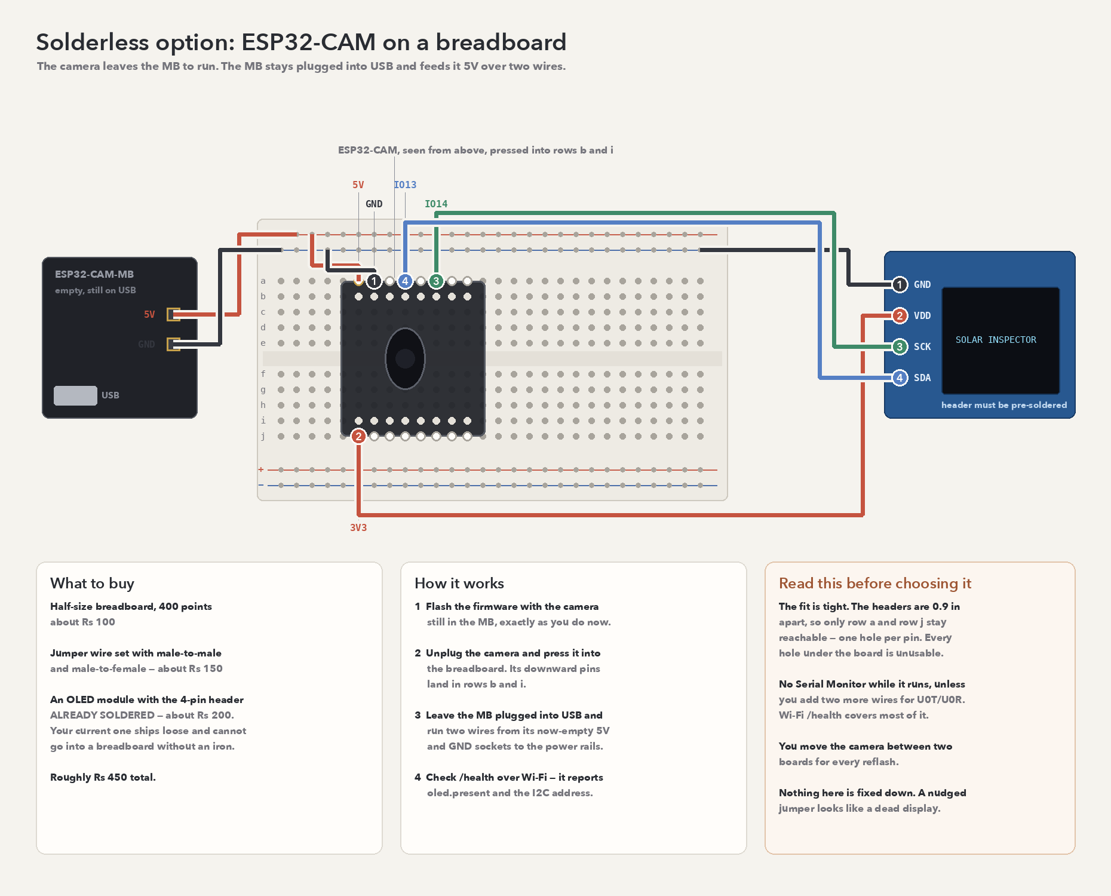
solar_defect_camera/design/oled-breadboard.png
