ajayspatil7/solar-detect/solar_defect_camera/design/oled-font-preview-5x8.png

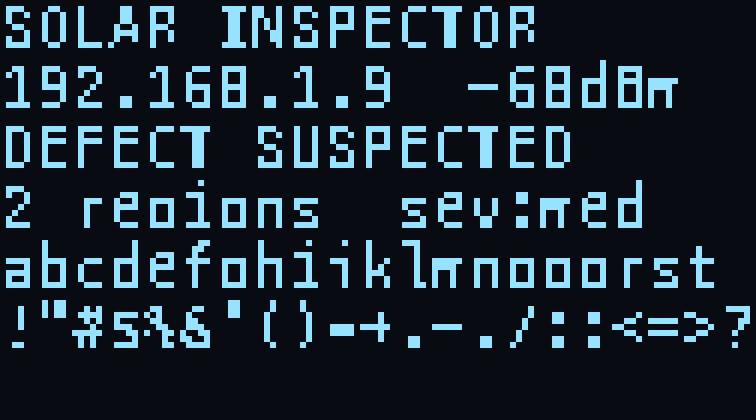
solar_defect_camera/design/oled-font-preview-5x8.png
