ajayspatil7/solar-detect/solar_defect_camera/design/oled-overview.png

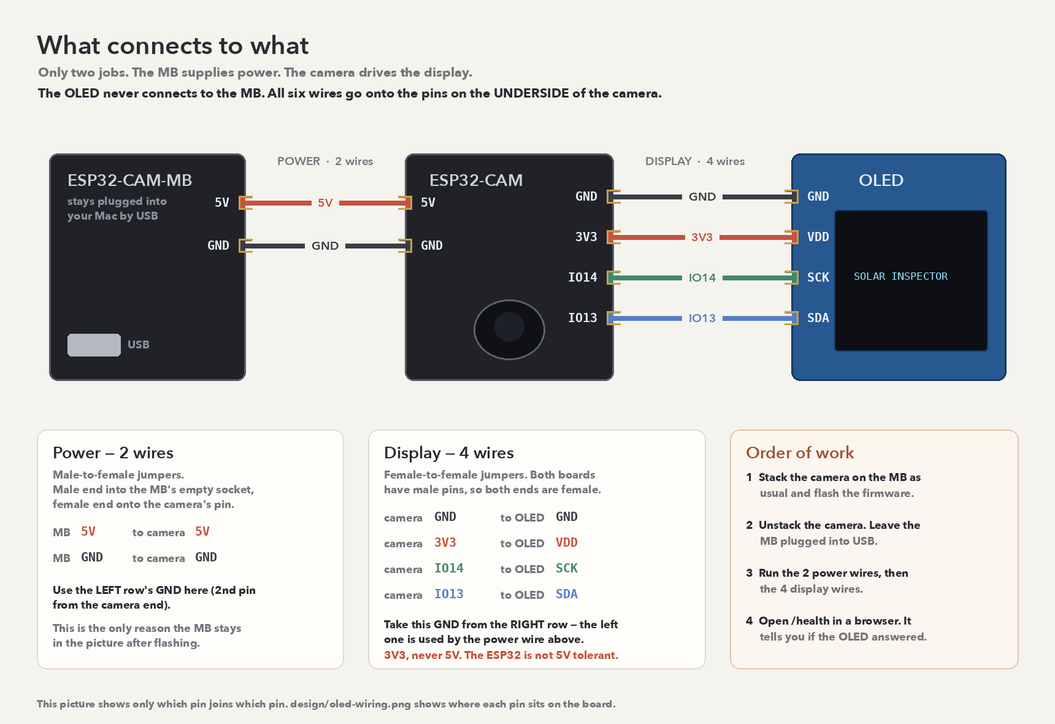
solar_defect_camera/design/oled-overview.png
