ajayspatil7/solar-detect/solar_defect_camera/design/oled-screens.png

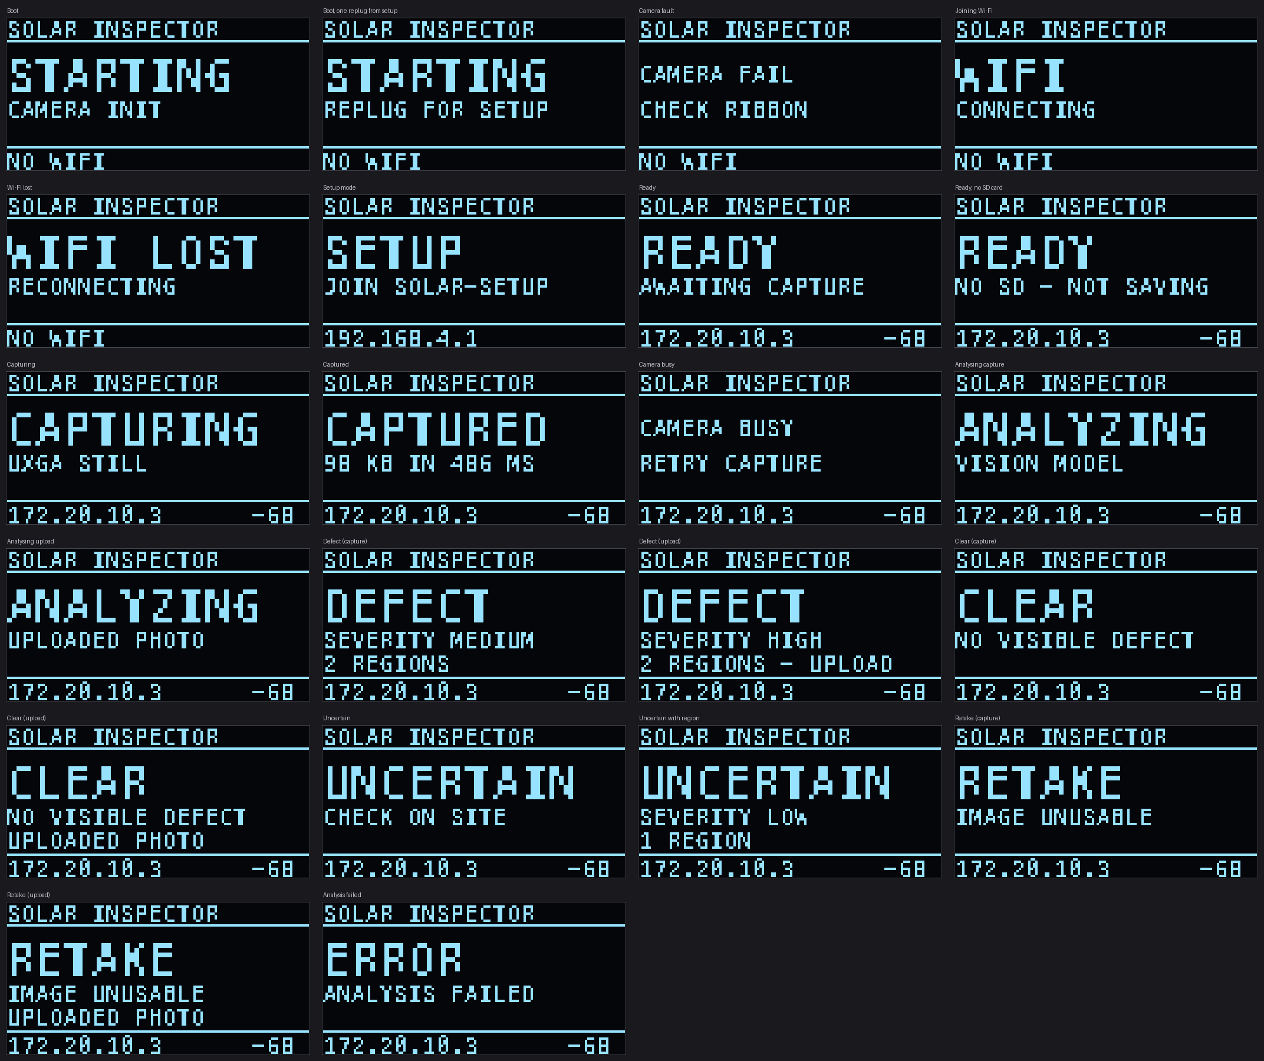
solar_defect_camera/design/oled-screens.png
