ajayspatil7/solar-detect/solar_defect_camera/design/phase2-implementation-1440-empty.png

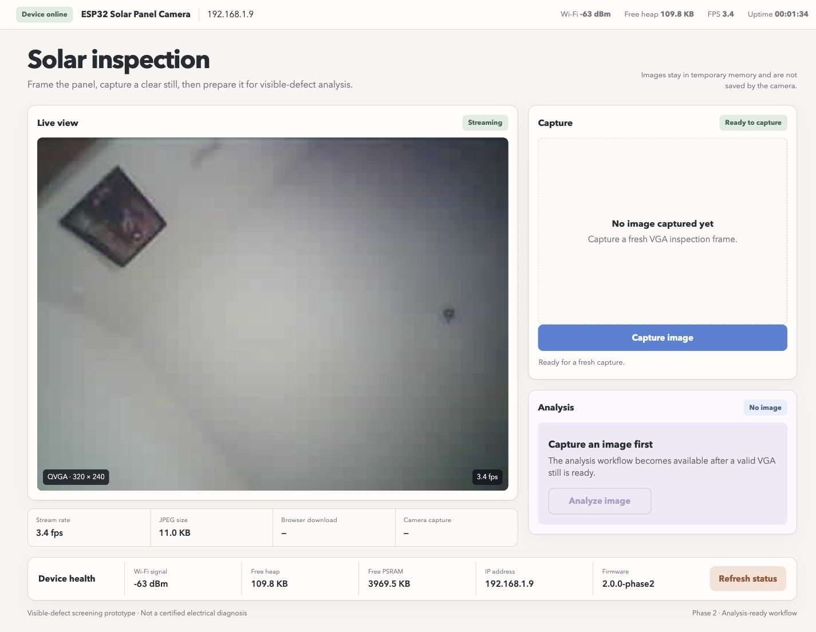
solar_defect_camera/design/phase2-implementation-1440-empty.png
