ajayspatil7/solar-detect/solar_defect_camera/design/phase2-implementation-mobile.png

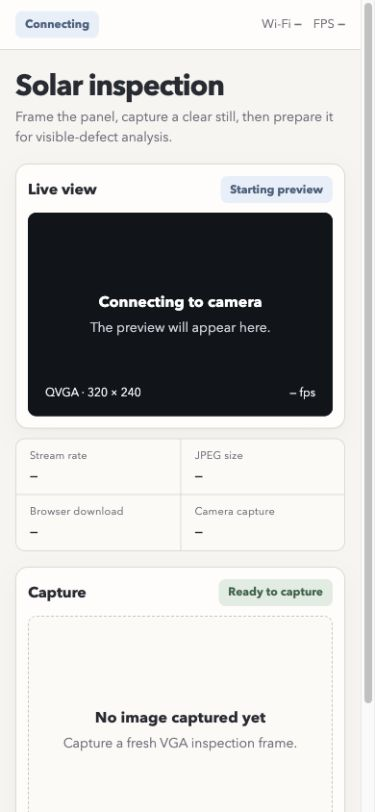
solar_defect_camera/design/phase2-implementation-mobile.png
