ajayspatil7/solar-detect/solar_defect_camera/design/phase2-soft-instrument-panel.png

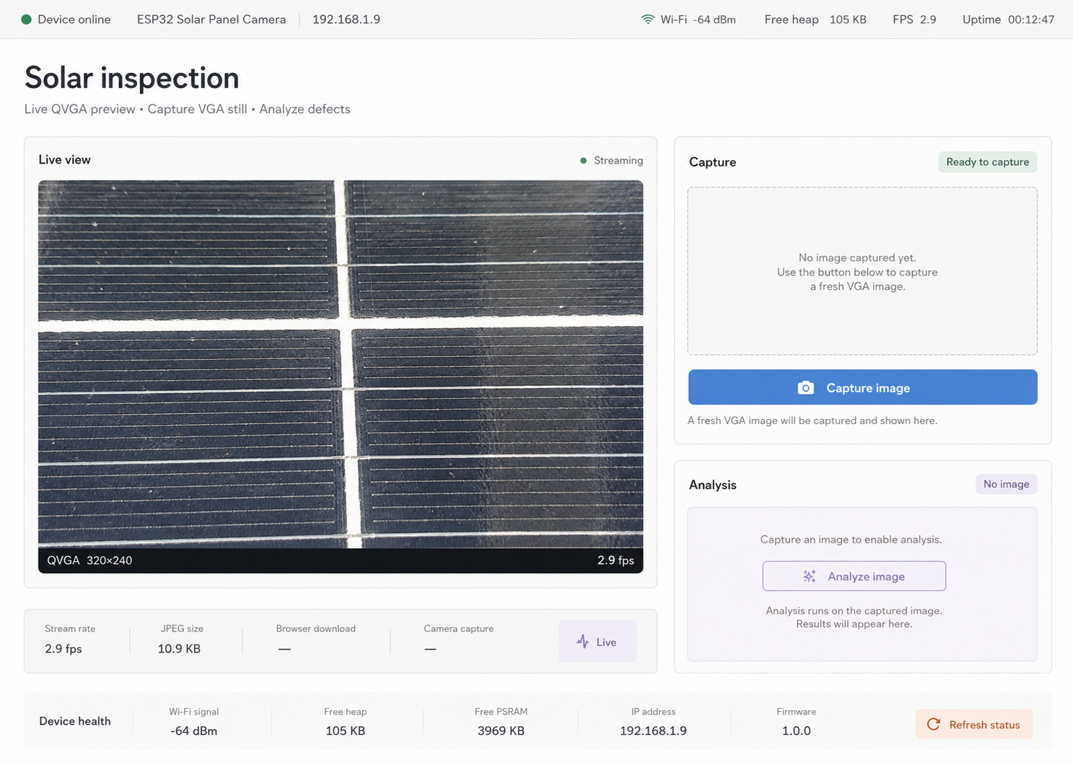
solar_defect_camera/design/phase2-soft-instrument-panel.png
