ajayspatil7/solar-detect/solar_defect_camera/design/slide-architecture.png

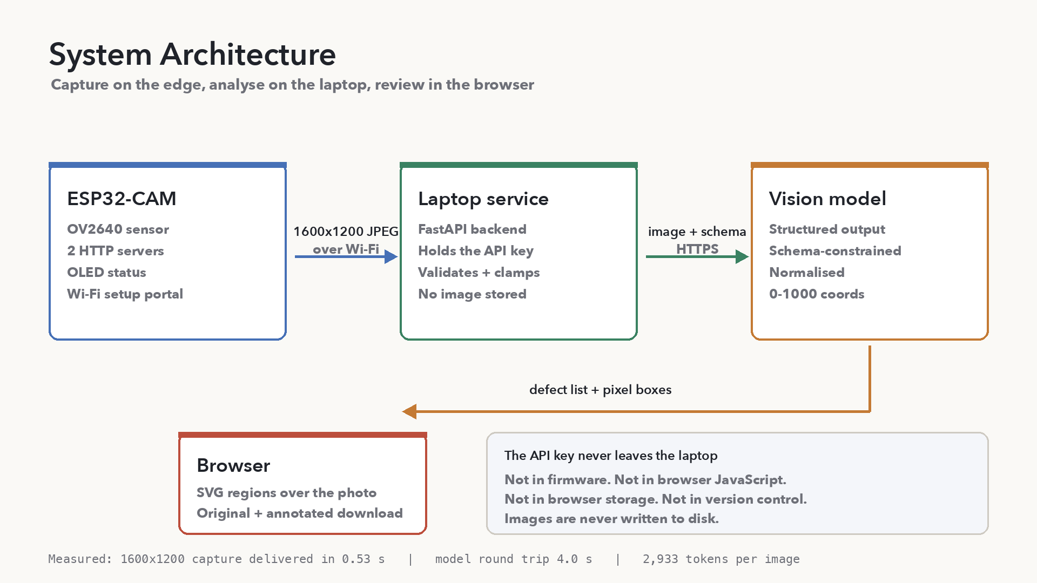
solar_defect_camera/design/slide-architecture.png
