ajayspatil7/solar-detect/solar_defect_camera/design/assembly-breadboard.png

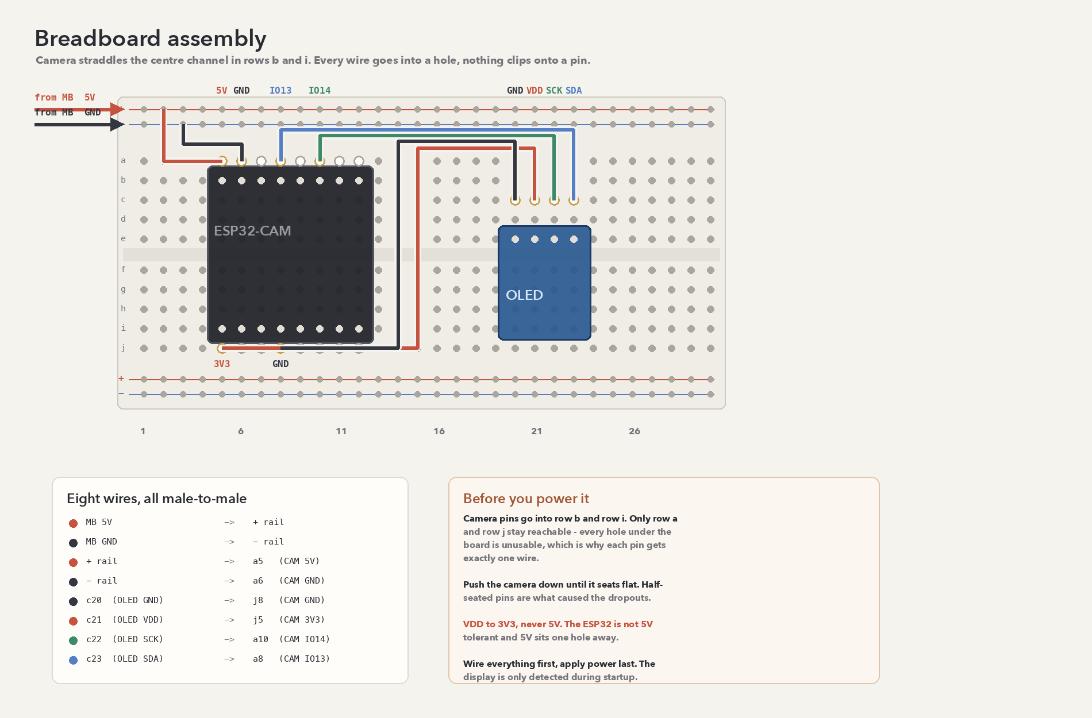
solar_defect_camera/design/assembly-breadboard.png
