ajayspatil7/solar-detect/solar_defect_camera/design/oled-wiring.png

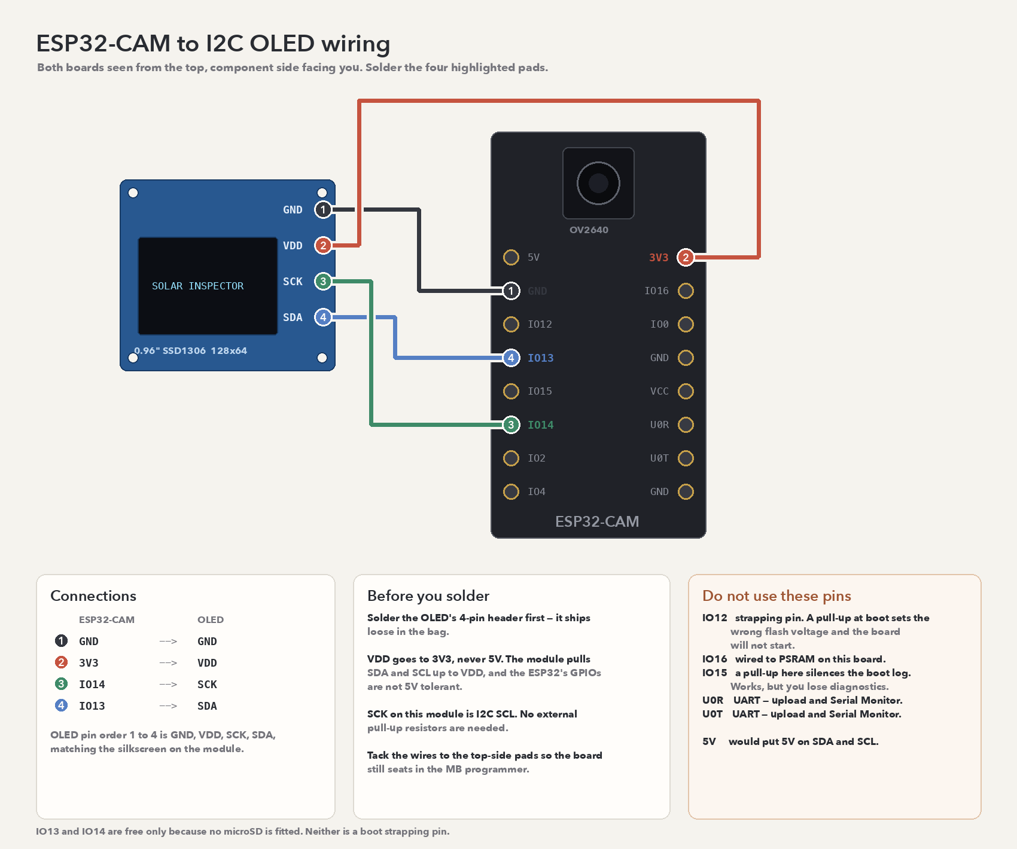
solar_defect_camera/design/oled-wiring.png
