ajayspatil7/solar-detect/solar_defect_camera/tools/preview_oled.py

"""Render the OLED status screens to a PNG for design review.

This mirrors renderDisplay() in solar_defect_camera.ino using the same
generated font, so the panel layout can be judged before hardware is wired.
It is a review aid, not a second implementation: if renderDisplay() changes,
update the LAYOUTS below to match.

    .venv/bin/python tools/preview_oled.py
"""

from __future__ import annotations

import re
from pathlib import Path

from PIL import Image, ImageDraw


PROJECT = Path(__file__).resolve().parents[1]
FONT_HEADER = PROJECT / "font5x8.h"
OUTPUT = PROJECT / "design" / "oled-screens.png"

WIDTH, HEIGHT = 128, 64
FONT_WIDTH, FONT_HEIGHT = 5, 8
SCALE = 4
IP = "172.20.10.3"
RSSI = "-68"

# label, headline, detail, defect count (None = not a result), upload, footer
# footer: "wifi" = address + signal, "setup" = access point address, "none" = NO WIFI
SCREENS = [
    ("Boot", "STARTING", "CAMERA INIT", None, False, "none"),
    ("Boot, one replug from setup", "STARTING", "REPLUG FOR SETUP", None, False, "none"),
    ("Camera fault", "CAMERA FAIL", "CHECK RIBBON", None, False, "none"),
    ("Joining Wi-Fi", "WIFI", "CONNECTING", None, False, "none"),
    ("Wi-Fi lost", "WIFI LOST", "RECONNECTING", None, False, "none"),
    ("Setup mode", "SETUP", "JOIN SOLAR-SETUP", None, False, "setup"),
    ("Ready", "READY", "AWAITING CAPTURE", None, False, "wifi"),
    ("Ready, no SD card", "READY", "NO SD - NOT SAVING", None, False, "wifi"),
    ("Capturing", "CAPTURING", "UXGA STILL", None, False, "wifi"),
    ("Captured", "CAPTURED", "98 KB IN 486 MS", None, False, "wifi"),
    ("Camera busy", "CAMERA BUSY", "RETRY CAPTURE", None, False, "wifi"),
    ("Analysing capture", "ANALYZING", "VISION MODEL", None, False, "wifi"),
    ("Analysing upload", "ANALYZING", "UPLOADED PHOTO", None, True, "wifi"),
    ("Defect (capture)", "DEFECT", "SEVERITY MEDIUM", 2, False, "wifi"),
    ("Defect (upload)", "DEFECT", "SEVERITY HIGH", 2, True, "wifi"),
    ("Clear (capture)", "CLEAR", "NO VISIBLE DEFECT", 0, False, "wifi"),
    ("Clear (upload)", "CLEAR", "NO VISIBLE DEFECT", 0, True, "wifi"),
    ("Uncertain", "UNCERTAIN", "CHECK ON SITE", 0, False, "wifi"),
    ("Uncertain with region", "UNCERTAIN", "SEVERITY LOW", 1, False, "wifi"),
    ("Retake (capture)", "RETAKE", "IMAGE UNUSABLE", 0, False, "wifi"),
    ("Retake (upload)", "RETAKE", "IMAGE UNUSABLE", 0, True, "wifi"),
    ("Analysis failed", "ERROR", "ANALYSIS FAILED", None, False, "wifi"),
]


def load_font() -> dict[str, list[int]]:
    text = FONT_HEADER.read_text()
    rows = re.findall(r"^  ((?:0x[0-9a-f]{2}, ){4}0x[0-9a-f]{2}),", text, re.M)
    glyphs = {}
    for index, row in enumerate(rows):
        glyphs[chr(32 + index)] = [int(b, 16) for b in row.split(", ")]
    return glyphs


class Panel:
    """A 1-bit framebuffer with the same primitives the driver exposes."""

    def __init__(self) -> None:
        self.pixels = [[0] * WIDTH for _ in range(HEIGHT)]

    def set_pixel(self, x: int, y: int) -> None:
        if 0 <= x < WIDTH and 0 <= y < HEIGHT:
            self.pixels[y][x] = 1

    def text(self, x: int, y: int, value: str, glyphs, scale: int = 1) -> None:
        for char in value.upper():
            columns = glyphs.get(char, glyphs["?"])
            for column, bits in enumerate(columns):
                for row in range(FONT_HEIGHT):
                    if not bits & (1 << row):
                        continue
                    for sy in range(scale):
                        for sx in range(scale):
                            self.set_pixel(x + column * scale + sx, y + row * scale + sy)
            x += (FONT_WIDTH + 1) * scale
            if x >= WIDTH:
                break

    def hline(self, y: int) -> None:
        for x in range(WIDTH):
            self.set_pixel(x, y)


def render(headline: str, detail: str, defects: int | None, upload: bool, footer: str, glyphs) -> Panel:
    """Mirrors renderDisplay() in solar_defect_camera.ino for a 128x64 panel."""
    panel = Panel()
    panel.text(0, 0, "SOLAR INSPECTOR", glyphs)
    panel.hline(9)

    scale = 2 if len(headline) <= 10 else 1
    panel.text(0, 15 if scale == 2 else 19, headline, glyphs, scale)

    next_y = 34
    if detail:
        panel.text(0, next_y, detail, glyphs)
        next_y = 44
    if defects is not None:  # a result screen
        line = ""
        if defects > 0:
            line = f"{defects} REGION{'' if defects == 1 else 'S'}{' - UPLOAD' if upload else ''}"
        elif upload:
            line = "UPLOADED PHOTO"
        if line:
            panel.text(0, next_y, line, glyphs)

    panel.hline(54)
    if footer == "setup":
        panel.text(0, 56, "192.168.4.1", glyphs)
    elif footer == "wifi":
        panel.text(0, 56, IP, glyphs)
        panel.text(WIDTH - 24, 56, RSSI, glyphs)
    else:
        panel.text(0, 56, "NO WIFI", glyphs)
    return panel


def main() -> None:
    glyphs = load_font()
    columns = 4
    rows = (len(SCREENS) + columns - 1) // columns
    cell_w, cell_h = WIDTH * SCALE + 24, HEIGHT * SCALE + 44
    image = Image.new("RGB", (columns * cell_w, rows * cell_h), (26, 26, 30))
    draw = ImageDraw.Draw(image)

    for index, (label, headline, detail, defects, upload, footer) in enumerate(SCREENS):
        for text in (headline, detail):
            assert len(text) <= 21, f"{label}: '{text}' is wider than the 21-character panel"
        panel = render(headline, detail, defects, upload, footer, glyphs)
        ox = (index % columns) * cell_w + 12
        oy = (index // columns) * cell_h + 32
        draw.rectangle([ox - 2, oy - 2, ox + WIDTH * SCALE + 1, oy + HEIGHT * SCALE + 1],
                       fill=(4, 6, 10), outline=(70, 70, 78))
        draw.text((ox, oy - 20), label, fill=(190, 190, 200))
        pixels = image.load()
        for y in range(HEIGHT):
            for x in range(WIDTH):
                if not panel.pixels[y][x]:
                    continue
                for sy in range(SCALE):
                    for sx in range(SCALE):
                        pixels[ox + x * SCALE + sx, oy + y * SCALE + sy] = (150, 226, 255)

    OUTPUT.parent.mkdir(parents=True, exist_ok=True)
    image.save(OUTPUT)
    print(f"Wrote {OUTPUT.relative_to(PROJECT)} — {len(SCREENS)} screens")


if __name__ == "__main__":
    main()
