ajayspatil7/solar-detect/solar_defect_camera/web_ui_gzip.h

#pragma once

// Generated from web_ui.h by tools/generate_web_ui.py.
const uint8_t PHASE3_INDEX_HTML_GZ[] PROGMEM = {
  0x1f, 0x8b, 0x08, 0x00, 0x00, 0x00, 0x00, 0x00, 0x02, 0x13, 0xbd, 0x7d, 0xed, 0x76, 0xdb, 0x38,
  0x92, 0xe8, 0xff, 0x79, 0x0a, 0xb6, 0x92, 0x1d, 0x89, 0xd3, 0x14, 0xf5, 0x69, 0x5b, 0xa6, 0x2c,
  0xe7, 0x26, 0xe9, 0xa4, 0xdb, 0xbb, 0xdd, 0x49, 0x36, 0x76, 0xcf, 0xcc, 0x9e, 0x4c, 0x36, 0xa6,
  0x48, 0x48, 0x62, 0x9b, 0x22, 0x35, 0x24, 0x65, 0x59, 0x2d, 0xeb, 0x9c, 0x7d, 0x88, 0x7b, 0xce,
  0x7d, 0x83, 0xfb, 0x0a, 0xf7, 0xff, 0xdd, 0x37, 0x99, 0x27, 0xd9, 0xaa, 0x02, 0x40, 0x02, 0x24,
  0x65, 0x3b, 0xdb, 0x33, 0x3b, 0x73, 0x3a, 0x11, 0x81, 0x42, 0xa1, 0x50, 0xa8, 0x6f, 0x80, 0xcc,
  0xef, 0xce, 0xbe, 0xf1, 0x63, 0x2f, 0xdb, 0xae, 0x98, 0xb1, 0xc8, 0x96, 0xe1, 0xf9, 0xef, 0xce,
  0xf0, 0x2f, 0x23, 0x74, 0xa3, 0xf9, 0xa4, 0xc1, 0xa2, 0x06, 0x36, 0x30, 0xd7, 0x3f, 0xff, 0x9d,
  0x61, 0x9c, 0x2d, 0x59, 0xe6, 0x1a, 0xde, 0xc2, 0x4d, 0x52, 0x96, 0x4d, 0x1a, 0xeb, 0x6c, 0xd6,
  0x1e, 0x35, 0x8a, 0x8e, 0xc8, 0x5d, 0xb2, 0x49, 0xe3, 0x36, 0x60, 0x9b, 0x55, 0x9c, 0x64, 0x0d,
  0xc3, 0x8b, 0xa3, 0x8c, 0x45, 0x00, 0xb8, 0x09, 0xfc, 0x6c, 0x31, 0xf1, 0xd9, 0x6d, 0xe0, 0xb1,
  0x36, 0x3d, 0x58, 0x41, 0x14, 0x64, 0x81, 0x1b, 0xb6, 0x53, 0xcf, 0x0d, 0xd9, 0xa4, 0x57, 0xc1,
  0x92, 0x2d, 0xd8, 0x92, 0xb5, 0xbd, 0x38, 0x8c, 0x13, 0x05, 0xd1, 0xb3, 0xd9, 0xd1, 0x6c, 0xc0,
  0x18, 0x87, 0xce, 0x82, 0x2c, 0x64, 0xe7, 0x97, 0x71, 0xe8, 0x26, 0x46, 0x10, 0xa5, 0x2b, 0xe6,
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
  0x64, 0x1e, 0x44, 0x4e, 0x77, 0x3c, 0x75, 0xbd, 0x9b, 0x79, 0x12, 0xaf, 0x23, 0xdf, 0xb9, 0x75,
  0x93, 0x96, 0x94, 0x2b, 0x73, 0x4c, 0x42, 0x27, 0xda, 0x80, 0x89, 0xa6, 0x20, 0x24, 0xf8, 0x95,
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
};
const size_t PHASE3_INDEX_HTML_GZ_LEN = 9207;
