ajayspatil7/solar-detect/(commit log)

2026-09-06 Initial commit: ESP32-CAM solar panel defect inspector
    Prototype that captures a UXGA still on an AI-Thinker ESP32-CAM, sends it
    from the browser to a local FastAPI backend, and renders the model's
    structured visible-defect result as responsive SVG regions over the image.
    A 128x64 I2C OLED mirrors the inspection state on the device itself.
    The OpenAI key stays on the backend and never reaches firmware, browser
    JavaScript, or version control.
    Firmware 3.1.0-phase5, backend 3.1.0-phase4.
    [partitions.csv]
2026-09-06 Add Wi-Fi provisioning so the camera can move between networks
    The camera is being handed to a non-technical operator who will run it at
    their own location, so credentials can no longer be compiled in.
    Credentials now live in NVS. When none are stored, or the stored network
    cannot be joined, the firmware raises a "SOLAR-SETUP" access point and
    serves a setup page at 192.168.4.1 that scans for networks and stores the
    chosen one. The OLED shows the network to join and that address, so the
    operator needs no serial cable and no documentation to get started.
    secrets.h survives only as a developer convenience, and is ignored once a
    board has been provisioned or cleared. Without that, POST /forge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
    [provisioning.h, solar_defect_camera.ino]
2026-09-06 Add one-click launcher and pre-filled backend address
    The demo is being handed to a non-technical operator, so the setup steps
    (virtual environment, dependencies, API key, finding the camera, typing a
    backend address) all had to disappear behind a single double-click.
    "Start Solar Inspector.bat" finds a working Python, creates the private
    environment on first run, installs dependencies, then hands over to
    tools/launcher.py. The launcher asks for the API key once and stores it in
    the ignored .env.local, starts the analysis service, scans the local
    network for the camera, and opens the browser at the camera's page with
    the backend address already filled in.
    The browser page now accepts ?back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
2026-09-06 Make camera discovery survive weak links and Windows
    The first Windows run failed to find a camera that the browser could reach
    moments later, so the sweep was too impatient. It now checks the last known
    address first, then sweeps twice with a widening timeout and a smaller
    worker pool, since Windows tolerates large connection fan-outs less well
    than macOS. A successful discovery is remembered in .env.local as
    CAMERA_IP, making later runs near-instant.
    [launcher.py]
2026-09-07 Add PROJECT_INFO.md as the single source document for the project
    One file covering what the system does and deliberately does not do, the
    architecture and the reasoning behind it, hardware and pin choices, each
    software component, the result contract, the security model, measured
    results, engineering decisions, phase history, operating instructions,
    limitations and next steps.
    Written to be quotable: every figure is measured from the physical build
    rather than estimated, so it can be lifted directly into a report or deck
    without re-deriving anything.
2026-09-08 Add breadboard assembly diagram
    Jumper ends pushed onto the camera's pins kept losing contact and dropping
    the board mid-session. Moving the whole assembly onto a breadboard replaces
    every friction-fit clip with a gripped hole.
    The diagram fixes the camera in rows b and i, which is the only placement
    that leaves a reachable hole for each pin: the headers are 0.9 in apart, so
    rows a and j are the only ones not covered by the board itself.
    [generate_assembly_diagram.py]
2026-09-08 Target the demo hotspot in the Wi-Fi setup portal
    The demo always runs on one phone hotspot, so the setup page now pre-fills
    that network name and, when the scan finds it, selects the exact scanned
    SSID instead. iOS device names use a typographic apostrophe, so a hand-typed
    ASCII one would fail to match with no useful error; matching against the
    scan result removes that trap entirely.
    Only the password is left for the operator to enter.
    [provisioning.h]
2026-09-08 Make camera discovery fast on a phone hotspot
    An iPhone hotspot allocates 172.20.10.0/28 -- fourteen usable addresses --
    but the sweep assumed a /24 and probed 254, which took long enough on the
    demo laptop to look like a hang. The search now recognises that range and
    checks only those fourteen, and on other networks tries the low addresses
    first before widening.
2026-09-15 Record Phase 6 plan: root cause, SD storage, laptop dashboard
    Captures the client's three post-handover requirements and the decisions
    taken on each, including the SD/OLED pin conflict on IO14 and why SCL moves
    to IO3 rather than IO12 or IO4.
2026-09-15 Add clickable dashboard mockup for client approval
    The client found the current page cluttered. This mockup is the proposal to
    agree before any dashboard code is written.
    Two destinations only. Inspect puts the image first and the findings beside
    it in reading order: verdict and priority, then numbered regions that match
    the numbered boxes on the image, then the selected region's probable cause
    with its evidence, how to confirm it, and what to do. History is a filterable
    list by priority that opens any record, and a record reuses the same layout
    with a printable report. Device diagnostics sit behind one status indicator.
    All content is sample data and is labelled as such on the page.
    Co-A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
2026-09-15 Make the camera follow the laptop's Wi-Fi
    The camera cannot see which network the laptop is on, so moving it to a new
    location meant provisioning it by hand from a phone. The launcher now does
    that: when the camera is not on the laptop's network, it switches the laptop
    to the camera's SOLAR-SETUP network for a few seconds, confirms it is talking
    to the camera, sends the laptop's network name and password, and switches
    back. Reconnecting runs in a finally block so the laptop is never stranded on
    the setup network.
    A camera still connected to an old network that is in range never opens
    SOLAR-SETUP, so three quick replugs now force setup mode; the OLED confirms
    the count on the second one. The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
2026-09-15 Remember several Wi-Fi networks and add them over USB
    The camera held exactly one network, so moving between home and a client's
    hotspot meant re-provisioning every time. It now keeps up to five, scans once
    at boot, and joins the strongest saved network in range. With nothing
    familiar nearby it opens setup mode within seconds instead of timing out.
    Boards that stored a single network migrate automatically.
    Networks can be saved over the USB serial link while the camera is stacked
    on the programmer, via tools/add_wifi_usb.py. That keeps a home password out
    of firmware and out of version control; it is typed at a hidden prompt and
    never echoed.
    Also verifies the microSD card on this board wi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
2026-09-15 Store inspection records on the camera's microSD card
    The client wanted a record of every inspection kept on the device itself.
    Records live under /records: a fixed-width index where record N sits at a
    known offset, so listing and deleting are direct seeks however many records
    build up, plus a folder per inspection with the full image, a thumbnail and
    the analysis result. Ids are never reused, which lets the dashboard cache
    images; the ETag carries a per-card id so swapping cards cannot serve stale
    ones.
    Only analysed inspections become records. The camera keeps its latest
    capture in PSRAM, and saving sends just the result and a small thumbnail --
    retakes leave nothing on the card and the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
    [oled.h, records.h, solar_defect_camera.ino, test_records_device.py]
2026-09-15 Build the laptop dashboard from the approved mockup
    The client approved the mockup, so it is now the working interface, served
    by the backend at localhost:8000 and opened by the launcher.
    The backend is the gateway to the camera: the browser only ever talks to the
    local service, which captures, analyses, saves and fetches records on the
    camera. Only the live video is loaded straight from the camera. That removes
    the dashboard's dependence on cross-origin access -- so it works on the
    firmware already flashed -- and puts handling of a changing camera address
    in one place. Discovery moves from the launcher into backend/camera.py and
    is shared.
    One click runs capture, analysis and save, stream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
2026-10-03 Let the dashboard analyse an uploaded photo
    The client wants to check existing photos of panels, not only what the
    camera sees live. An Upload image button (and drag-and-drop onto the view)
    sends a JPEG, PNG or WebP to the new POST /api/upload.
    The photo is fitted onto the same 1600 x 1200 canvas a camera capture
    uses -- scaled and padded, never cropped, so a defect at the edge is kept --
    which leaves the analysis path and the result contract untouched. Uploads
    work with the camera offline. They are shown but not saved: the SD record
    store writes the camera's own held capture, so storing uploads would need
    firmware changes.
    Tested with four reference photos through the real vision model: b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
2026-10-03 Bring the checkpoint up to date
    Records the breadboard rebuild without power rails, the photo upload
    feature and its real-model test results, the investigation into the live
    view dropping to about 1 fps on the home Wi-Fi, and the re-flash of
    3.3.0-phase6 that delivered the fixes pending since 15 September.
2026-10-21 Log every network the camera hears at start-up
    A hotspot that the camera could not see looked identical, in the log, to
    one saved under the wrong name: both just reported "1 in range". Listing
    each network found by the boot scan, with channel and signal, showed the
    real cause in one restart -- an iPhone stops advertising its hotspot to new
    devices while its Personal Hotspot screen is closed.
    The checkpoint records the investigation into the slow link: on a phone
    hotspot one metre away, with a -27 to -32 dBm signal, the camera still
    sends a 100 KB photo in 9-15 s, against about 0.5 s in September, on any
    access point, channel, transmit power or power source. The sensor takes
    the photo in und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
2026-10-21 Make the Windows laptop easy to update and run
    Updating the client's laptop meant opening a terminal and typing a git
    command. "Update Solar Inspector.bat" does it with a double-click, pulls
    fast-forward only so a local change can never be overwritten, and leaves
    the API key alone. On a laptop without Git, or with a folder that came from
    a ZIP, it opens the download page and says which file to carry over.
    HOW-TO-RUN-ON-WINDOWS.md is the one page an operator needs: one-time setup,
    the steps for each session, updating, and what to do when the camera screen
    is blank, shows SETUP, or cannot be found. It includes the iPhone hotspot
    detail that caught us -- the hotspot must stay on its settings s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
2026-10-21 Show uploaded photos' results on the camera's screen
    After Upload image, the OLED kept the verdict of the previous camera
    capture -- RETAKE for a dark desk shot -- while the dashboard said the
    uploaded photo had no defects, because the upload path never told the
    camera anything. Uploads now send ANALYZING and then the real verdict, or
    ANALYSIS FAILED, marked as coming from an upload.
    The updates go through one background worker: they stay in order, and an
    upload never waits on a camera that may be unplugged, since uploads are
    meant to work without it. Works with the firmware already on the camera.
2026-10-21 Tidy the OLED's result screens
    Checked every screen the camera can show, rendered with its own font:
    - the region count appears only when there is something to count, so
    CLEAR and RETAKE no longer say "0 REGIONS"
    - results for an uploaded photo are marked, so they cannot be mistaken
    for the camera's own capture
    - UNCERTAIN says CHECK ON SITE instead of leaving the line empty
    - the analysing screen says VISION MODEL or UPLOADED PHOTO, not
    "UPLOADED TO MAC", which was wrong on the client's Windows laptop
    - the two text lines move up two pixels, so the third no longer touches
    the footer rule
    preview_oled.py now covers all 22 screens and fails if any line is wider
    than the panel. Firmw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
2026-10-21 Show possible causes instead of "not determinable"
    When the model cannot single out one cause -- common for cracks -- the
    dashboard said "Cause not determinable from the image", a dead end. The
    knowledge base already knows which causes can produce each kind of
    defect, so an undetermined cause now carries that short list, and the
    dashboard shows "3 possible causes - check on site" with each cause, its
    urgency, and the checks that tell them apart. Saved records from before
    get the new wording too.
    The camera's screen also stops saying "UPLOADED TO MAC" without a
    re-flash: firmware older than 3.3.2 prints that on its analysing screen,
    so the backend now reads the camera's firmware version and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
2026-10-28 Stop "Camera not found" flickering during live view
    On the slow camera board, the dashboard's 15-second status check missed
    now and then while the live view was streaming, and a single miss showed
    "Camera not found" until the next check succeeded.
    The check gave the camera 2.5 seconds and made two requests -- one to
    confirm the address, one for its health. It now makes one, allows 6
    seconds, and treats a camera that answered in the last 45 seconds as still
    there when a check is missed. A camera silent for longer is still reported.
    Requests to the camera also skip the extra confirmation when it answered
    recently, which takes load off the link, and one failed request no longer
    throws away the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
2026-10-28 Let the operator choose the Wi-Fi when the inspector starts
    Wi-Fi was the step that kept going wrong at the client's: the laptop on
    one network and the camera on another, or an iPhone hotspot the camera
    could not see. Start Solar Inspector now shows which network the laptop is
    on and lists the ones it can see, strongest first. Press Enter to keep it
    or type a number to switch; the password is asked for only if Windows has
    not joined that network before. Networks the camera cannot use -- 5 GHz
    only, or ones needing a username -- are marked and refused, and the iPhone
    hotspot tips (Maximize Compatibility, keep the Personal Hotspot screen
    open) are shown every time. The camera search and hand-o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
